vpcsln/spartacus_PCB_REV1/v1sch.csv

Reference | Qty | Value | Footprint | Description
C1,C2,C3,C4,C5,C6,C7,C12,C14,C16,C19,C20,C22,C25,C26,C27,C39,C40,C42,C44,C50,C66,C67,C68,C69,C71,C72,C74,C75,C76,C89,C90,C94,C95,C98,C99 | 36 | 100n | Capacitor_SMD:C_1206_3216Metric_Pad1.33x1.80mm_HandSolder | Unpolarized capacitor,Unpolarized capacitor, small symbol
C8,C9,C41,C45,C77,C78,C79,C82,C83,C84,C91,C93,C102,C103,C104,C105,C106 | 17 | 1u | Capacitor_SMD:C_1206_3216Metric_Pad1.33x1.80mm_HandSolder | Unpolarized capacitor,Unpolarized capacitor, small symbol
C10,C11,C31,C32,C36,C37,C55,C97 | 8 | 22u | Capacitor_SMD:C_1206_3216Metric_Pad1.33x1.80mm_HandSolder | Unpolarized capacitor, small symbol
C13,C17,C18,C21,C23,C38,C43,C51,C52,C53,C70,C100,C101 | 13 | 10u | Capacitor_SMD:C_1206_3216Metric_Pad1.33x1.80mm_HandSolder | Unpolarized capacitor,Unpolarized capacitor, small symbol
C15 | 1 | 1000uF | Capacitor_THT:CP_Radial_D10.0mm_P5.00mm | Unpolarized capacitor, small symbol
C24,C54,C56,C57,C60,C61,C62,C85,C86,C87 | 10 | 2.2u | Capacitor_SMD:C_1206_3216Metric_Pad1.33x1.80mm_HandSolder | Unpolarized capacitor, small symbol
C28,C30,C33,C35 | 4 | 4.7n | Capacitor_SMD:C_1206_3216Metric_Pad1.33x1.80mm_HandSolder | Unpolarized capacitor, small symbol
C29,C34 | 2 | 10n | Capacitor_SMD:C_1206_3216Metric_Pad1.33x1.80mm_HandSolder | Unpolarized capacitor, small symbol
C46,C47,C48,C49 | 4 | 33n | Capacitor_SMD:C_1206_3216Metric_Pad1.33x1.80mm_HandSolder | Unpolarized capacitor, small symbol
C58,C59 | 2 | 47n | Capacitor_SMD:C_1206_3216Metric_Pad1.33x1.80mm_HandSolder | Unpolarized capacitor, small symbol
C63,C64 | 2 | 47p | Capacitor_SMD:C_1206_3216Metric_Pad1.33x1.80mm_HandSolder | Unpolarized capacitor, small symbol
C65,C80,C81,C88,C92,C96 | 6 | 1n | Capacitor_SMD:C_1206_3216Metric_Pad1.33x1.80mm_HandSolder | Unpolarized capacitor, small symbol
C73 | 1 | 470u | Capacitor_THT:CP_Radial_D8.0mm_P3.50mm | Unpolarized capacitor, small symbol
C107 | 1 | 100n | easyeda2kicad:CAP-TH_L4.0-W2.6-P2.5-D0.5 | Unpolarized capacitor, small symbol
C401,C402,C403,C404 | 4 | C_Small | easyeda2kicad:CAP-TH_L4.0-W2.6-P2.5-D0.5 | Unpolarized capacitor, small symbol
C514,C523 | 2 | 390p | easyeda2kicad:CAP-TH_L4.0-W2.6-P2.5-D0.5 | Unpolarized capacitor, small symbol
C515 | 1 | 180p | easyeda2kicad:CAP-TH_L4.0-W2.6-P2.5-D0.5 | Unpolarized capacitor, small symbol
C516,C531,C535 | 3 | 220p | easyeda2kicad:CAP-TH_L4.0-W2.6-P2.5-D0.5 | Unpolarized capacitor, small symbol
C517 | 1 | 820p | easyeda2kicad:CAP-TH_L4.0-W2.6-P2.5-D0.5 | Unpolarized capacitor, small symbol
C518 | 1 | 470p | easyeda2kicad:CAP-TH_L4.0-W2.6-P2.5-D0.5 | Unpolarized capacitor, small symbol
C519,C532,C536 | 3 | 560p | easyeda2kicad:CAP-TH_L4.0-W2.6-P2.5-D0.5 | Unpolarized capacitor, small symbol
C520 | 1 | 56p | easyeda2kicad:CAP-TH_L4.0-W2.6-P2.5-D0.5 | Unpolarized capacitor, small symbol
C521 | 1 | 82p | easyeda2kicad:CAP-TH_L4.0-W2.6-P2.5-D0.5 | Unpolarized capacitor, small symbol
C522,C533,C537 | 3 | 33p | easyeda2kicad:CAP-TH_L4.0-W2.6-P2.5-D0.5 | Unpolarized capacitor, small symbol
C524,C525,C534,C538 | 4 | 270p | easyeda2kicad:CAP-TH_L4.0-W2.6-P2.5-D0.5 | Unpolarized capacitor, small symbol
CN1 | 1 |  | HansAdafruit:DCJACK_2MM_PTH | 2.0mm DC Barrel JackDCJACK_2MM_PTH - Through Hole Jack (4UConnector: 05537)
D2,D3,D4,D5 | 4 | D_Zener | Diode_THT:D_DO-41_SOD81_P3.81mm_Vertical_CathodeUp | Zener diode
D6,D7,D8,D9,D18 | 5 | 1N4148 | Diode_THT:D_DO-35_SOD27_P2.54mm_Vertical_CathodeUp | 100V 0.15A standard switching diode, DO-35
D10,D11,D12,D13,D14,D15,D20,D21,D22,D23 | 10 | 1N4007 | Diode_THT:D_DO-41_SOD81_P3.81mm_Vertical_CathodeUp | 1000V 1A General Purpose Rectifier Diode, DO-41
D16,D17,D19 | 3 | SS14 | Diode_SMD:D_SMA | 40V 1A Schottky Diode, SMA
D24,D25,D26,D27 | 4 | LESD8D5.0CAT5G | Diode_SMD:D_SOD-882D
JP1,JP5,JP8,JP9 | 4 |  | HansPinhead:1X01 | PIN HEADER
JP2 | 1 |  | HansPinhead:1X06 | PIN HEADER
JP3 | 1 |  | HansPinhead:1X08 | PIN HEADER
JP4 | 1 |  | HansPinhead:1X04 | PIN HEADER
JP6 | 1 |  | adafruit:1X03 | PIN HEADER
JP7 | 1 |  | HansPinhead:1X07 | PIN HEADER
JP10,JP11 | 2 |  | HansPinhead:1X03 | PIN HEADER
JP12,JP13 | 2 |  | HansPinhead:2X03 | PIN HEADER
JP14,JP15,JP16,JP17,JP18 | 5 |  | HansPinhead:1X02 | PIN HEADER
JP19,JP20 | 2 |  | adafruit:1X08-BIG | PIN HEADER
L1,L2 | 2 |  | HansToroid:T37_INDUCTOR | Inductor wound on a T37 Toroid
L3,L4,L6,L7,L8,L9,L509,L514,L522 | 9 | 47u | Inductor_THT:L_Axial_L9.5mm_D4.0mm_P2.54mm_Vertical_Fastron_SMCC | Inductor, small symbol
L5 | 1 | 330u | Inductor_THT:L_Axial_L9.5mm_D4.0mm_P2.54mm_Vertical_Fastron_SMCC | Inductor, small symbol
L401 | 1 |  | HansToroid:T50_TAPPED_INDUCTOR_FLAT
L506,L508,L510,L511,L512,L513,L515,L516,L517,L518 | 10 |  | HansToroid:T50_INDUCTOR | Inductor wound on a T37 Toroid
LED1,LED2 | 2 |  | HansAva:HLMP-1790
MIC_2 | 1 |  | HansPinhead:1X02 | PIN HEADER
Q1,Q2,Q16 | 3 | APM4953_C5185739 | easyeda2kicad2:SOP-8_L5.1-W3.9-P1.27-LS6.0-BL
Q3,Q4,Q5,Q6 | 4 |  | easyeda2kicad2:SOT54E_LYING_100_LH2 | N-CHANNEL MOS FET
Q7,Q8,Q9,Q10,Q11,Q13,Q14,Q17,Q28,Q29,Q30,Q31,Q32,Q33 | 14 | BSS123 | Package_TO_SOT_SMD:SOT-23 | 0.17A Id, 100V Vds, N-Channel MOSFET, SOT-23
Q12,Q18,Q19,Q23,Q25 | 5 | BC817 | Package_TO_SOT_SMD:SOT-23 | 0.8A Ic, 45V Vce, NPN Transistor, SOT-23
Q15 | 1 | BSS84 | Package_TO_SOT_SMD:SOT-23 | -0.13A Id, -50V Vds, P-Channel MOSFET, SOT-23
Q20,Q27 | 2 |  | HansTransistor:DPAK4
Q21,Q22,Q24,Q26 | 4 | BC857 | Package_TO_SOT_SMD:SOT-23 | 0.1A Ic, 45V Vce, PNP Transistor, SOT-23
R1,R12,R13,R14,R15,R16,R17,R18,R19,R20,R21,R22,R23,R24,R25,R26,R27,R28,R29,R30,R31,R112,R113,R114,R115 | 25 | 10 | Resistor_SMD:R_1206_3216Metric_Pad1.30x1.75mm_HandSolder | Resistor,Resistor, small symbol
R2,R7,R35,R36,R47,R48,R49,R50,R51,R52,R53,R66,R67,R82,R83,R84,R86,R89,R90,R94,R95,R98,R101,R102,R103,R110,R119,R121,R126,R129,R132,R136,R137,R138,R155,R156,R157 | 37 | 10k | Resistor_SMD:R_1206_3216Metric_Pad1.30x1.75mm_HandSolder | Resistor,Resistor, small symbol
R3,R4,R88,R91,R99,R100,R116,R122,R123,R124 | 10 | 5.1k | Resistor_SMD:R_1206_3216Metric_Pad1.30x1.75mm_HandSolder | Resistor,Resistor, small symbol
R5,R118,R128,R130 | 4 | 47k | Resistor_SMD:R_1206_3216Metric_Pad1.30x1.75mm_HandSolder | Resistor,Resistor, small symbol
R6,R8,R70,R71,R72,R73,R111,R141,R142 | 9 | 470k | Resistor_SMD:R_1206_3216Metric_Pad1.30x1.75mm_HandSolder | Resistor,Resistor, small symbol
R9,R10,R33,R74,R77,R96,R104,R139,R143 | 9 | 1k | Resistor_SMD:R_1206_3216Metric_Pad1.30x1.75mm_HandSolder | Resistor,Resistor, small symbol
R11,R80,R81,R85,R106,R109,R152,R153,R154 | 9 | 100k | Resistor_SMD:R_1206_3216Metric_Pad1.30x1.75mm_HandSolder | Resistor, small symbol
R32,R38,R40,R43,R45,R131,R134,R135,R145,R146 | 10 | 470 | Resistor_SMD:R_1206_3216Metric_Pad1.30x1.75mm_HandSolder | Resistor,Resistor, small symbol
R34,R144 | 2 | 10K | Resistor_SMD:R_1206_3216Metric_Pad1.30x1.75mm_HandSolder | Resistor
R37,R41,R44,R46,R149,R150,R151 | 7 | 47 | Resistor_SMD:R_1206_3216Metric_Pad1.30x1.75mm_HandSolder | Resistor, small symbol
R39,R42 | 2 | 100 | Resistor_SMD:R_1206_3216Metric_Pad1.30x1.75mm_HandSolder | Resistor, small symbol
R54,R55,R58,R59,R92,R93,R107,R108,R147 | 9 | 0 | Resistor_SMD:R_1206_3216Metric_Pad1.30x1.75mm_HandSolder | Resistor, small symbol
R56,R62,R117,R125 | 4 | 5.6k | Resistor_SMD:R_1206_3216Metric_Pad1.30x1.75mm_HandSolder | Resistor, small symbol
R57,R63 | 2 | 3.3k | Resistor_SMD:R_1206_3216Metric_Pad1.30x1.75mm_HandSolder | Resistor, small symbol
R60,R61,R87,R133 | 4 | 22k | Resistor_SMD:R_1206_3216Metric_Pad1.30x1.75mm_HandSolder | Resistor, small symbol
R64,R65 | 2 | 560 | Resistor_SMD:R_1206_3216Metric_Pad1.30x1.75mm_HandSolder | Resistor, small symbol
R68,R69 | 2 | 267k | Resistor_SMD:R_1206_3216Metric_Pad1.30x1.75mm_HandSolder | Resistor, small symbol
R75,R76 | 2 | 33 | Resistor_SMD:R_1206_3216Metric_Pad1.30x1.75mm_HandSolder | Resistor, small symbol
R78,R79 | 2 | 49.9 | Resistor_SMD:R_1206_3216Metric_Pad1.30x1.75mm_HandSolder | Resistor, small symbol
R97,R105,R140 | 3 | 2.2k | Resistor_SMD:R_1206_3216Metric_Pad1.30x1.75mm_HandSolder | Resistor, small symbol
R120,R127 | 2 | 1.91k | Resistor_SMD:R_1206_3216Metric_Pad1.30x1.75mm_HandSolder | Resistor, small symbol
R148 | 1 | 0 | Resistor_SMD:R_01005_0402Metric | Resistor, small symbol
RF1 | 1 | DOSIN-801-0050 | easyeda2kicad:BNC-TH_DOSIN-801-0051
SW6,SW7,SW8,SW9,SW10,SW11,SW12,SW13 | 8 | TS1701-CZ55HBS | easyeda2kicad:SW-TH_4P-L7.5-W5.5-P4.50
T1,T2 | 2 |  | HansToroid:BN43-202-TAP
T3 | 1 |  | HansToroid:BN43-202_BRIDGE | BN43-202 SWR bridge
T5 | 1 |  | HansToroid:BN43-1502_BRIDGE | BN43-202 SWR bridge
T401 | 1 |  | HansToroid:T37_TRIFILAR_TRANSFORMER
U1 | 1 | STM32G474VETx | Package_QFP:LQFP-100_14x14mm_P0.5mm | STMicroelectronics Arm Cortex-M4 MCU, 512KB flash, 128KB RAM, 170 MHz, 1.71-3.6V, 86 GPIO, LQFP100
U2 | 1 | DSC1003DL2-008.0000T | Package_DFN_QFN:CDFN-4_2x2.5mm_P1.65mm
U3,U15,U16,U20,U21,U22,U23,U24 | 8 | UAD8C05L01_C3001951 | easyeda2kicad:SOD-882_L1.0-W0.6-BI
U4 | 1 | UZ1085L-33-TN3-R | Package_TO_SOT_SMD:TO-252-3_TabPin2
U5,U6 | 2 | UCC27524D | Package_SO:SOIC-8_3.9x4.9mm_P1.27mm | Dual 5A MOSFET driver, 4.5V..18V supply, non-inverting, SOIC-8
U7,U8 | 2 | MC74ACT541DTR2G | easyeda2kicad:TSSOP-20_L6.5-W4.4-P0.65-LS6.4-BL
U9,U12 | 2 | TLV9062xD | Package_SO:SOIC-8_3.9x4.9mm_P1.27mm | Dual operational amplifier, 300 uV Offset, SOIC-8
U10,U11 | 2 | SN74CBT3253 | Package_SO:SOIC-16_3.9x9.9mm_P1.27mm | Dual 1 to 4 Analog Multiplexer
U13 | 1 | PCM1821QRTERQ1 | footprints:WQFN20_RTE_TEX
U14 | 1 | NE5532 | Package_SO:SOIC-8_3.9x4.9mm_P1.27mm | Dual Low-Noise Operational Amplifiers, DIP-8/SOIC-8
U17,U18 | 2 | 161N-4BVS11 | easyeda2kicad2:USB-C-SMD_HANELECTRICITY_161N-4XVS11
U19 | 1 | LM1084IT-5.0G | easyeda2kicad:TO-220-3_L9.9-W4.5-P2.54-L
X1,X2,X3 | 3 |  | HansMicEar:PJ320A | MIC/HEADPHONE JACK3.5mm stereo microphone/headphone jackPJ320D
