vpcsln/spartacus_PCB_REV1/v1sch.kicad_pcb

## KiCad design v1sch.kicad_pcb (2026-10-18)

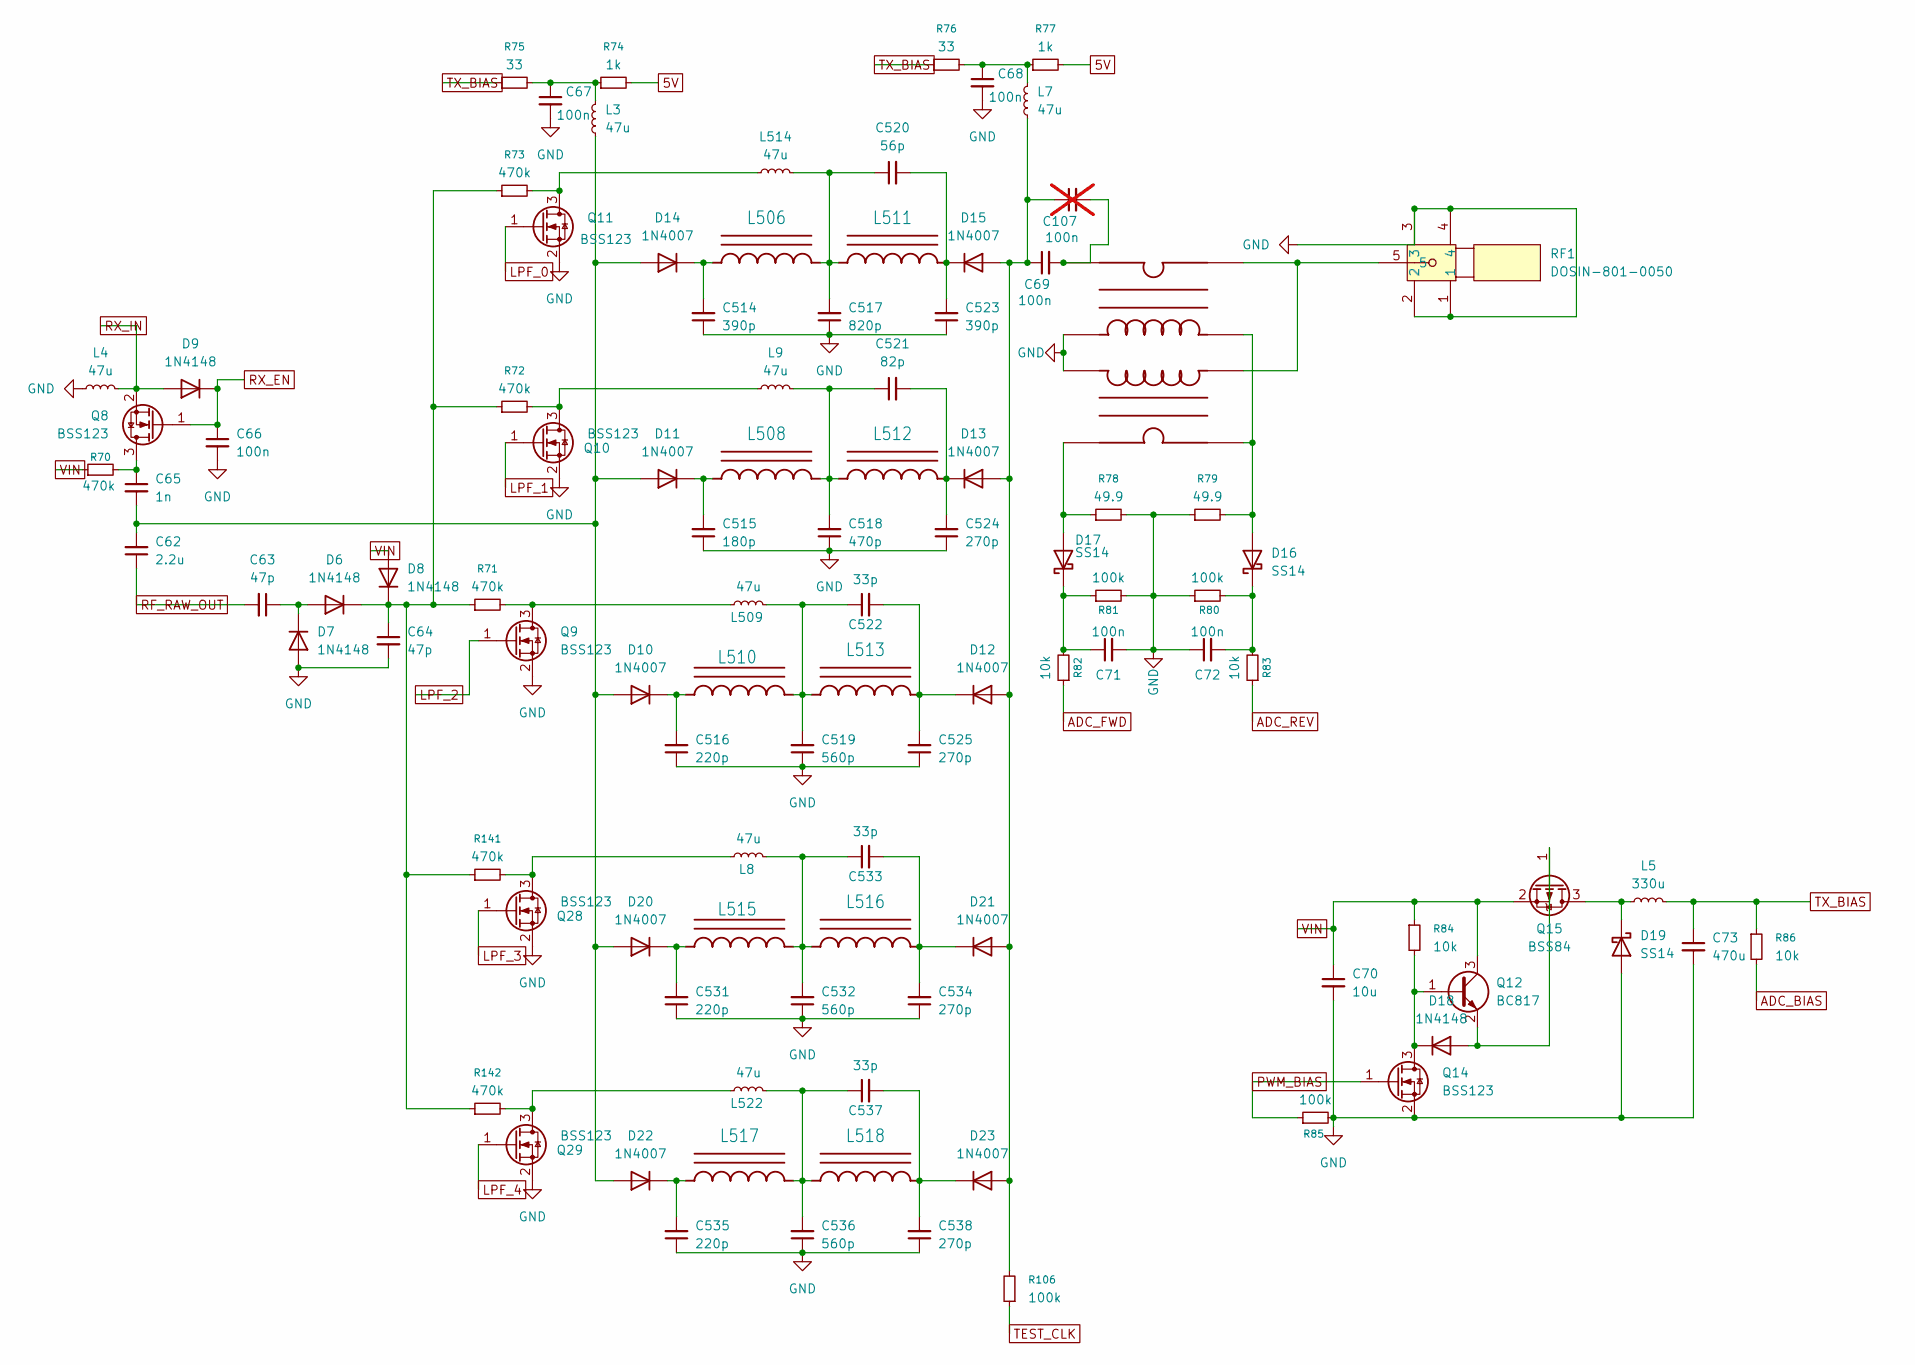
[picture p1: schematic filters.kicad_sch]

Parts:
C62: 2.2u; C_1206_3216Metric_Pad1.33x1.80mm_HandSolder
C63, C64: 47p; C_1206_3216Metric_Pad1.33x1.80mm_HandSolder
C65: 1n; C_1206_3216Metric_Pad1.33x1.80mm_HandSolder
C66, C67, C68, C69, C71, C72: 100n; C_1206_3216Metric_Pad1.33x1.80mm_HandSolder
C70: 10u; C_1206_3216Metric_Pad1.33x1.80mm_HandSolder
C73: 470u; CP_Radial_D8.0mm_P3.50mm
C107: 100n; CAP-TH_L4.0-W2.6-P2.5-D0.5; not fitted
C514, C523: 390p; CAP-TH_L4.0-W2.6-P2.5-D0.5
C515: 180p; CAP-TH_L4.0-W2.6-P2.5-D0.5
C516, C531, C535: 220p; CAP-TH_L4.0-W2.6-P2.5-D0.5
C517: 820p; CAP-TH_L4.0-W2.6-P2.5-D0.5
C518: 470p; CAP-TH_L4.0-W2.6-P2.5-D0.5
C519, C532, C536: 560p; CAP-TH_L4.0-W2.6-P2.5-D0.5
C520: 56p; CAP-TH_L4.0-W2.6-P2.5-D0.5
C521: 82p; CAP-TH_L4.0-W2.6-P2.5-D0.5
C522, C533, C537: 33p; CAP-TH_L4.0-W2.6-P2.5-D0.5
C524, C525, C534, C538: 270p; CAP-TH_L4.0-W2.6-P2.5-D0.5
D6, D7, D8, D9, D18: 1N4148; D_DO-35_SOD27_P2.54mm_Vertical_CathodeUp
D10, D11, D12, D13, D14, D15, D20, D21, D22, D23: 1N4007; D_DO-41_SOD81_P3.81mm_Vertical_CathodeUp
D16, D17, D19: SS14; D_SMA
L3, L4, L7, L8, L9, L509, L514, L522: 47u; L_Axial_L9.5mm_D4.0mm_P2.54mm_Vertical_Fastron_SMCC
L5: 330u; L_Axial_L9.5mm_D4.0mm_P2.54mm_Vertical_Fastron_SMCC
L506, L508, L510, L511, L512, L513, L515, L516, L517, L518: T50_INDUCTOR
Q8, Q9, Q10, Q11, Q14, Q28, Q29: BSS123; SOT-23
Q12: BC817; SOT-23
Q15: BSS84; SOT-23
R70, R71, R72, R73, R141, R142: 470k; R_1206_3216Metric_Pad1.30x1.75mm_HandSolder
R74, R77: 1k; R_1206_3216Metric_Pad1.30x1.75mm_HandSolder
R75, R76: 33; R_1206_3216Metric_Pad1.30x1.75mm_HandSolder
R78, R79: 49.9; R_1206_3216Metric_Pad1.30x1.75mm_HandSolder
R80, R81, R85, R106: 100k; R_1206_3216Metric_Pad1.30x1.75mm_HandSolder
R82, R83, R84, R86: 10k; R_1206_3216Metric_Pad1.30x1.75mm_HandSolder
RF1: DOSIN-801-0050; BNC-TH_DOSIN-801-0051; MPN DOSIN-801-0050; LCSC Part C521210
T5: BN43-1502_BRIDGE

Connections:
5V: R74.2, R77.2; also elsewhere on the board
ADC_BIAS: R86.2; also elsewhere on the board
ADC_FWD: R82.1; also elsewhere on the board
ADC_REV: R83.1; also elsewhere on the board
GND: C64.2, C66.2, C67.2, C68.2, C70.2, C71.2, C72.1, C73.2, C514.1, C515.1, C516.1, C517.1, C518.1, C519.1, C523.1, C524.1, C525.1, C531.1, C532.1, C534.1, C535.1, C536.1, C538.1, D7.2 (A), D19.2 (A), L4.1, Q9.2 (S), Q10.2 (S), Q11.2 (S), Q14.2 (S), Q28.2 (S), Q29.2 (S), R78.2, R79.1, R80.1, R81.2, R85.2, RF1.1, RF1.2, RF1.3, RF1.4, T5.C2B, T5.C3B; also elsewhere on the board
LPF_0: Q11.1 (G); also elsewhere on the board
LPF_1: Q10.1 (G); also elsewhere on the board
LPF_2: Q9.1 (G); also elsewhere on the board
LPF_3: Q28.1 (G); also elsewhere on the board
LPF_4: Q29.1 (G); also elsewhere on the board
unnamed: C67.1, L3.2, R74.1, R75.2
unnamed: C68.1, L7.2, R76.2, R77.1
unnamed: C69.2, C107.2, T5.C4B
unnamed: C517.2, C520.1, L506.CA, L511.CB, L514.2
unnamed: C518.2, C521.1, L9.2, L508.CA, L512.CB
unnamed: C519.2, C522.1, L509.2, L510.CA, L513.CB
unnamed: C532.2, C533.1, L8.2, L515.CA, L516.CB
unnamed: C536.2, C537.1, L517.CA, L518.CB, L522.2
unnamed: C63.1, D6.2 (A), D7.1 (K)
unnamed: C64.1, D6.1 (K), D8.1 (K), R71.1, R72.1, R73.1, R141.1, R142.1
unnamed: C62.2, C65.2, D10.2 (A), D11.2 (A), D14.2 (A), D20.2 (A), D22.2 (A), L3.1
unnamed: C516.2, D10.1 (K), L510.CB
unnamed: C515.2, D11.1 (K), L508.CB
unnamed: C69.1, C107.1, D12.2 (A), D13.2 (A), D15.2 (A), D21.2 (A), D23.2 (A), L7.1, R106.2
unnamed: C522.2, C525.2, D12.1 (K), L513.CA
unnamed: C521.2, C524.2, D13.1 (K), L512.CA
unnamed: C514.2, D14.1 (K), L506.CB
unnamed: C520.2, C523.2, D15.1 (K), L511.CA
unnamed: D16.2 (A), R79.2, T5.C1A, T5.C3A
unnamed: C72.2, D16.1 (K), R80.2, R83.2
unnamed: D17.2 (A), R78.1, T5.C1B
unnamed: C71.1, D17.1 (K), R81.1, R82.2
unnamed: D18.2 (A), Q12.2 (E), Q15.1 (G)
unnamed: D18.1 (K), Q12.1 (B), Q14.3 (D), R84.2
unnamed: D19.1 (K), L5.1, Q15.3 (D)
unnamed: C531.2, D20.1 (K), L515.CB
unnamed: C533.2, C534.2, D21.1 (K), L516.CA
unnamed: C535.2, D22.1 (K), L517.CB
unnamed: C537.2, C538.2, D23.1 (K), L518.CA
unnamed: C65.1, Q8.3 (D), R70.2
unnamed: L509.1, Q9.3 (D), R71.2
unnamed: L9.1, Q10.3 (D), R72.2
unnamed: L514.1, Q11.3 (D), R73.2
unnamed: L8.1, Q28.3 (D), R141.2
unnamed: L522.1, Q29.3 (D), R142.2
unnamed: RF1.5, T5.C2A, T5.C4A
PWM_BIAS: Q14.1 (G), R85.1; also elsewhere on the board
RF_RAW_OUT: C62.1, C63.2; also elsewhere on the board
RX_EN: C66.1, D9.1 (K), Q8.1 (G); also elsewhere on the board
RX_IN: D9.2 (A), L4.2, Q8.2 (S); also elsewhere on the board
TEST_CLK: R106.1; also elsewhere on the board
TX_BIAS: C73.1, L5.2, R75.1, R76.1, R86.1
VIN: C70.1, D8.2 (A), Q12.3 (C), Q15.2 (S), R70.1, R84.1; also elsewhere on the board

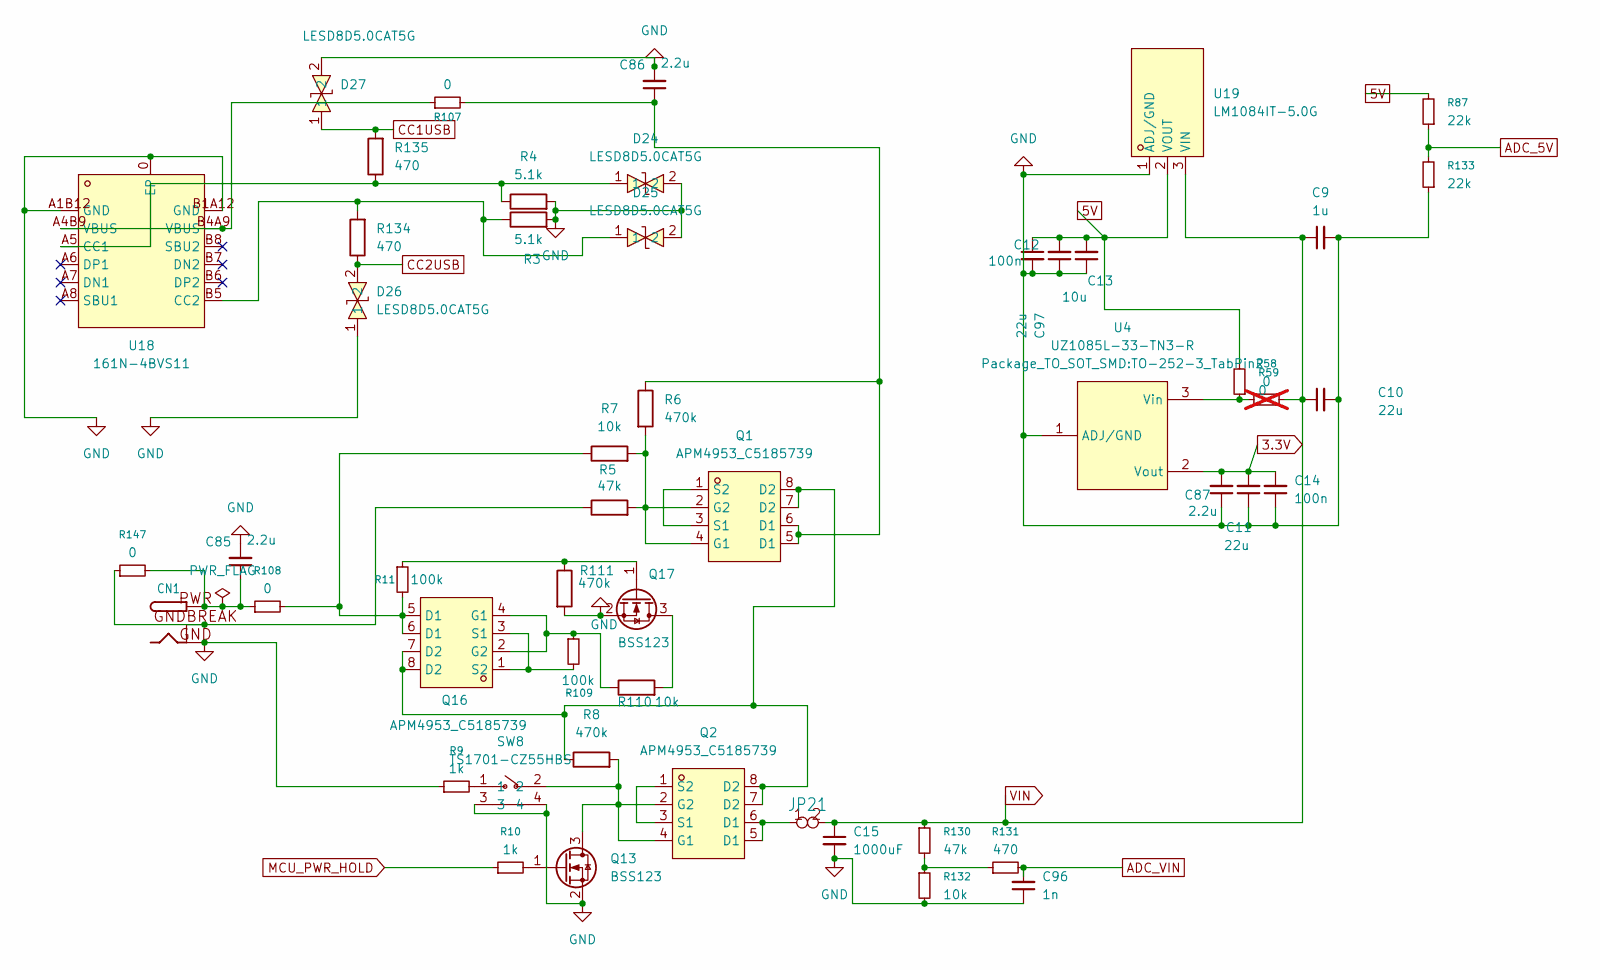
[picture p2: schematic untitled.kicad_sch]

Parts:
C9: 1u; C_1206_3216Metric_Pad1.33x1.80mm_HandSolder
C10, C11, C97: 22u; C_1206_3216Metric_Pad1.33x1.80mm_HandSolder
C12, C14: 100n; C_1206_3216Metric_Pad1.33x1.80mm_HandSolder
C13: 10u; C_1206_3216Metric_Pad1.33x1.80mm_HandSolder
C15: 1000uF; CP_Radial_D10.0mm_P5.00mm
C85, C86, C87: 2.2u; C_1206_3216Metric_Pad1.33x1.80mm_HandSolder
C96: 1n; C_1206_3216Metric_Pad1.33x1.80mm_HandSolder
CN1: DCJACK_2MM_PTH
D24, D25, D26, D27: LESD8D5.0CAT5G; D_SOD-882D; MPN LESD8D5.0CAT5G; LCSC Part C172411
JP21: 1X02
Q1, Q2, Q16: APM4953_C5185739; SOP-8_L5.1-W3.9-P1.27-LS6.0-BL; MPN APM4953(UMW); LCSC Part C5185739
Q13, Q17: BSS123; SOT-23
R3, R4: 5.1k; R_1206_3216Metric_Pad1.30x1.75mm_HandSolder
R5, R130: 47k; R_1206_3216Metric_Pad1.30x1.75mm_HandSolder
R6, R8, R111: 470k; R_1206_3216Metric_Pad1.30x1.75mm_HandSolder
R7, R110, R132: 10k; R_1206_3216Metric_Pad1.30x1.75mm_HandSolder
R9, R10: 1k; R_1206_3216Metric_Pad1.30x1.75mm_HandSolder
R11, R109: 100k; R_1206_3216Metric_Pad1.30x1.75mm_HandSolder
R58: 0; R_1206_3216Metric_Pad1.30x1.75mm_HandSolder; not fitted
R59, R107, R108, R147: 0; R_1206_3216Metric_Pad1.30x1.75mm_HandSolder
R87, R133: 22k; R_1206_3216Metric_Pad1.30x1.75mm_HandSolder
R131, R134, R135: 470; R_1206_3216Metric_Pad1.30x1.75mm_HandSolder
SW8: TS1701-CZ55HBS; SW-TH_4P-L7.5-W5.5-P4.50; MPN TS1701-CZ55HBS; LCSC Part C36938820
U4: UZ1085L-33-TN3-R; TO-252-3_TabPin2; MPN UZ1085L-33-TN3-R; LCSC Part C125622
U18: 161N-4BVS11; USB-C-SMD_HANELECTRICITY_161N-4XVS11; MPN 161N-4BVS11; LCSC Part C5440752
U19: LM1084IT-5.0G; TO-220-3_L9.9-W4.5-P2.54-L; MPN LM1084IT-5.0G; LCSC Part C5145342

Connections:
3.3V: C11.2, C14.2, C87.2, U4.2 (Vout); also elsewhere on the board
5V: C12.2, C13.2, C97.1, R59.2, R87.2, U19.2 (VOUT); also elsewhere on the board
ADC_5V: R87.1, R133.2; also elsewhere on the board
ADC_VIN: C96.2, R131.2; also elsewhere on the board
CC1USB: D27.1, R135.2; also elsewhere on the board
CC2USB: D26.2, R134.1; also elsewhere on the board
GND: C9.2, C10.2, C11.1, C12.1, C13.1, C14.1, C15.2, C85.2, C86.2, C87.1, C96.1, C97.2, CN1.GND, D24.2, D25.2, D26.1, D27.2, Q13.2 (S), Q17.2 (S), R3.2, R4.2, R9.1, R111.2, R132.2, R133.1, SW8.3, SW8.4, U4.1 (ADJ/GND), U18.0 (EP), U18.A1B12 (GND), U18.B1A12 (GND), U19.1 (ADJ/GND); also elsewhere on the board
MCU_PWR_HOLD: R10.1; also elsewhere on the board
unnamed: C85.1, CN1.PWR, R108.1, R147.2
unnamed: C86.1, Q1.5 (D1), Q1.6 (D1), R6.1, R107.2
unnamed: CN1.GNDBREAK, R5.1, R147.1
unnamed: JP21.1, Q2.5 (D1), Q2.6 (D1)
unnamed: Q1.7 (D2), Q1.8 (D2), Q2.7 (D2), Q2.8 (D2), Q16.7 (D2), Q16.8 (D2), R8.1
unnamed: Q1.2 (G2), Q1.4 (G1), R5.2, R6.2, R7.2
unnamed: Q1.1 (S2), Q1.3 (S1)
unnamed: Q2.1 (S2), Q2.3 (S1)
unnamed: Q2.2 (G2), Q2.4 (G1), Q13.3 (D), R8.2, SW8.2
unnamed: Q13.1 (G), R10.2
unnamed: Q16.5 (D1), Q16.6 (D1), R7.1, R11.2, R108.2
unnamed: Q16.2 (G2), Q16.4 (G1), R109.1, R110.1
unnamed: Q16.1 (S2), Q16.3 (S1), R109.2
unnamed: Q17.3 (D), R110.2
unnamed: Q17.1 (G), R11.1, R111.1
unnamed: R9.2, SW8.1
unnamed: R107.1, U18.A4B9 (VBUS), U18.B4A9 (VBUS)
unnamed: R130.2, R131.1, R132.1
unnamed: R58.1, R59.1, U4.3 (Vin)
unnamed: D24.1, R4.1, R135.1, U18.A5 (CC1)
unnamed: D25.1, R3.1, R134.2, U18.B5 (CC2)
VIN: C9.1, C10.1, C15.1, JP21.2, R58.2, R130.1, U19.3 (VIN); also elsewhere on the board

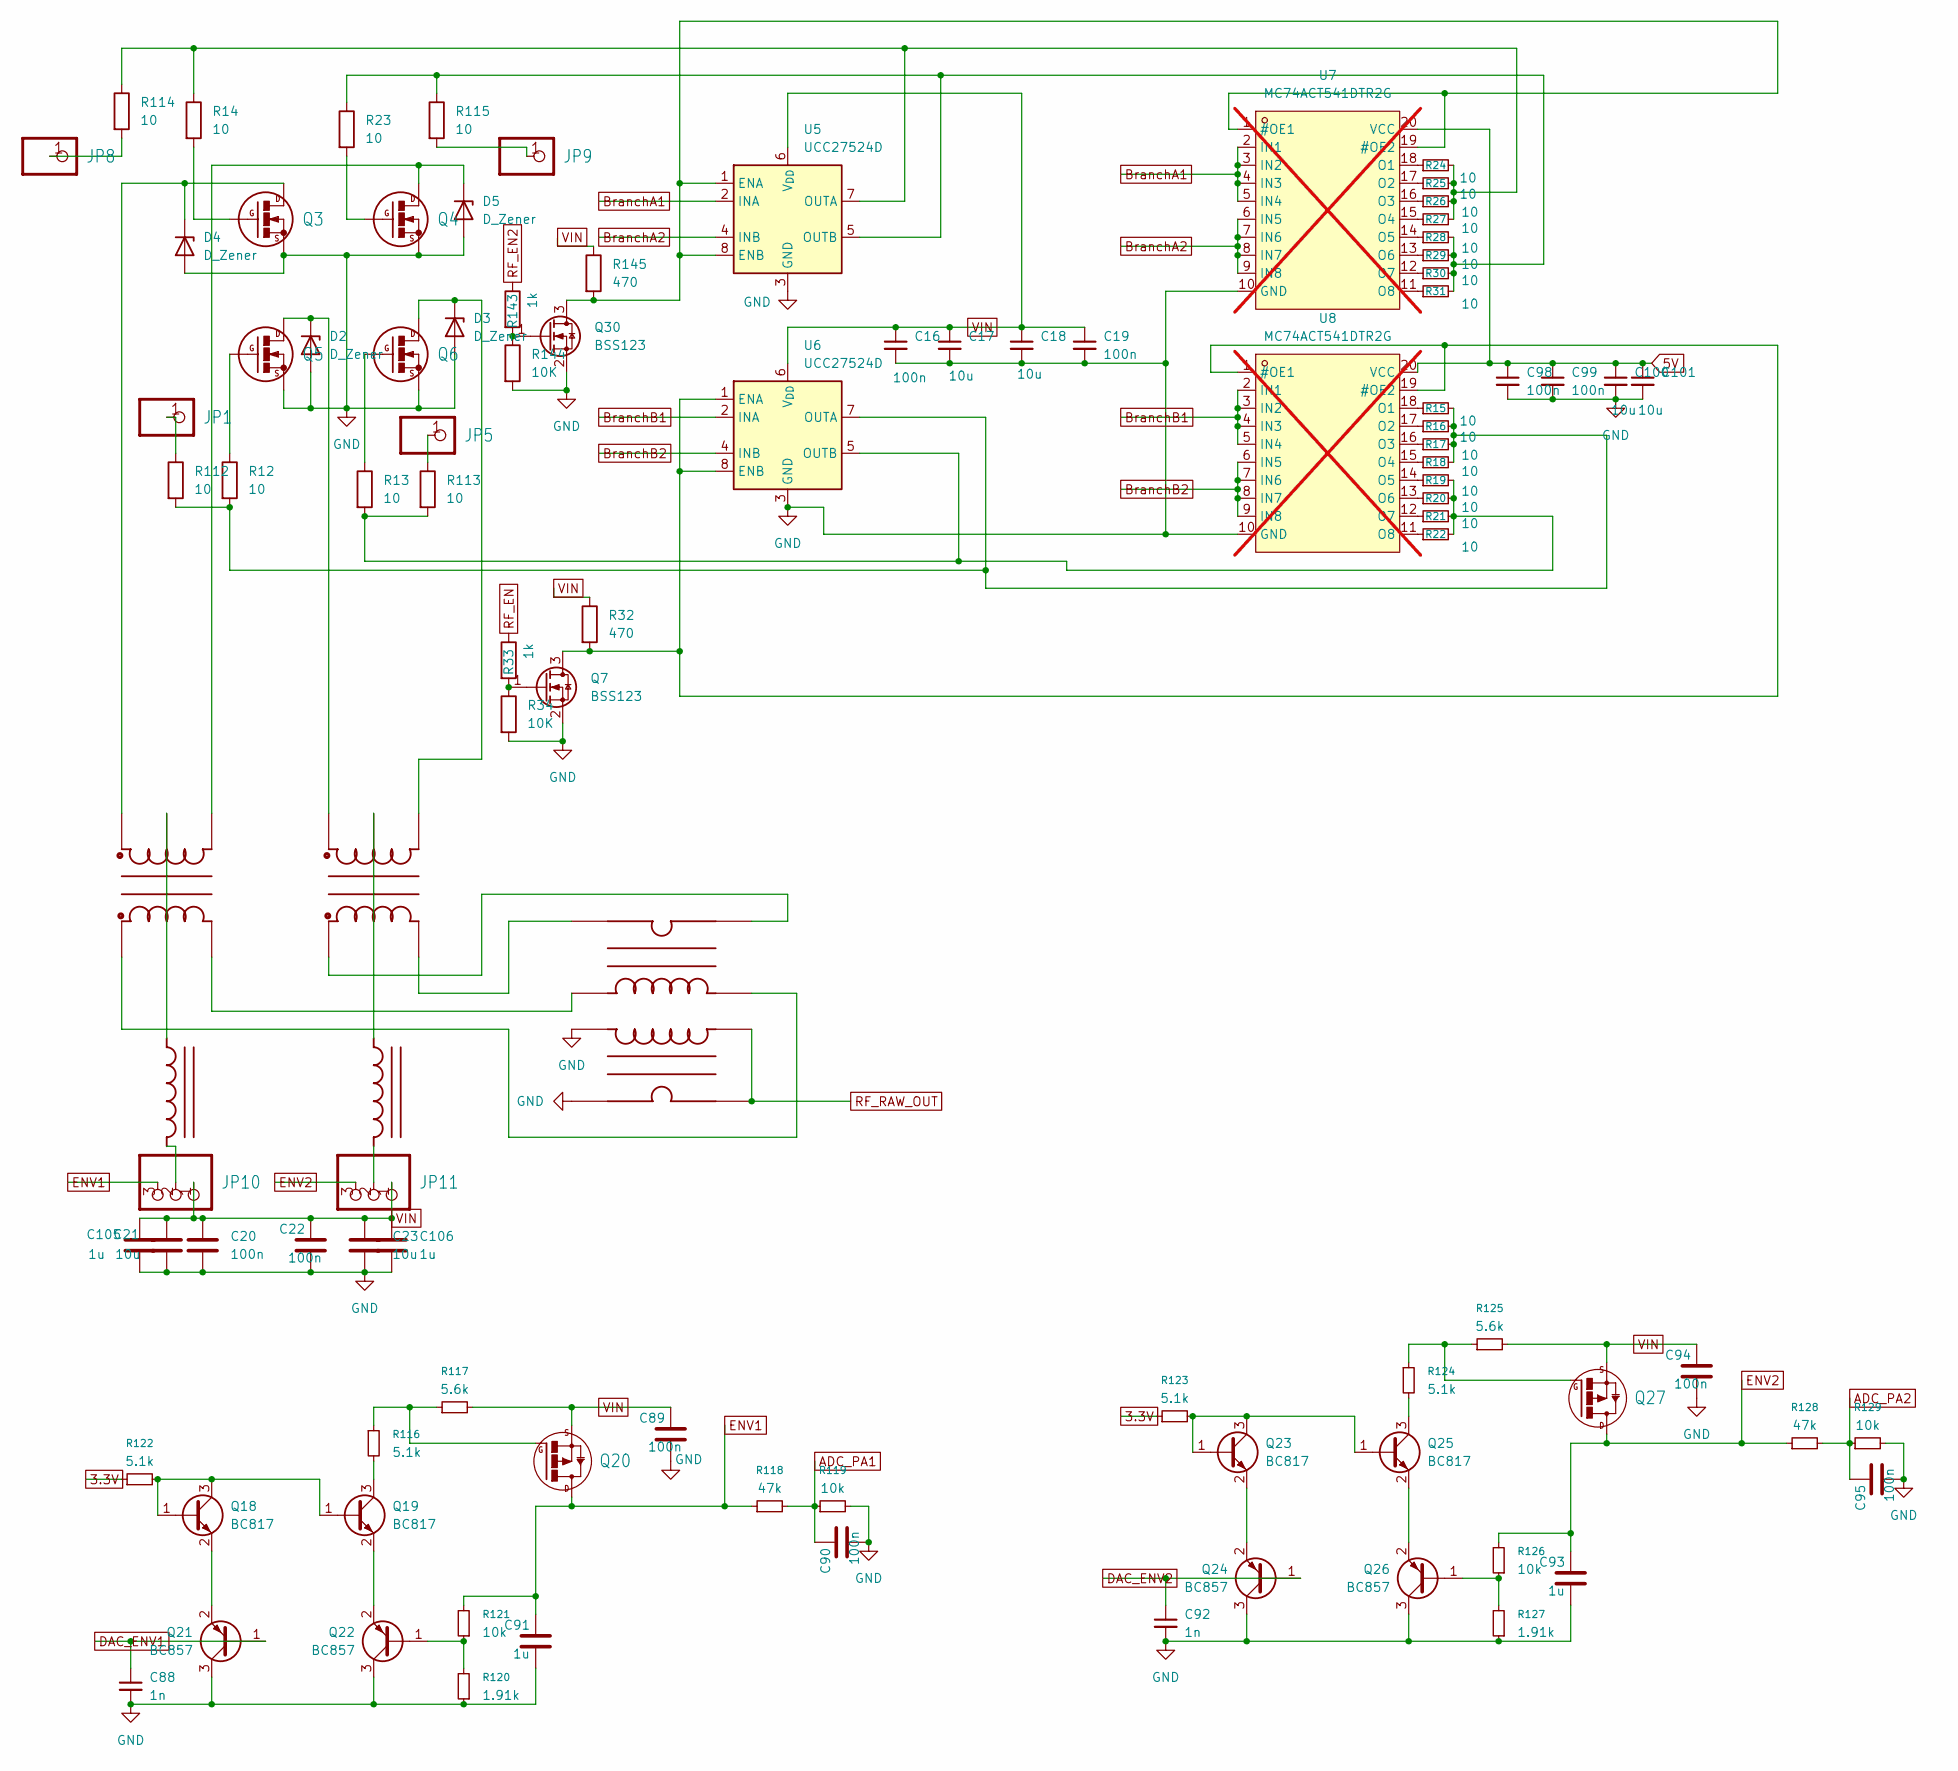
[picture p3: schematic Transmitter.kicad_sch]

Parts:
C16, C19, C20, C22, C89, C90, C94, C95, C98, C99: 100n; C_1206_3216Metric_Pad1.33x1.80mm_HandSolder
C17, C18, C21, C23, C100, C101: 10u; C_1206_3216Metric_Pad1.33x1.80mm_HandSolder
C88, C92: 1n; C_1206_3216Metric_Pad1.33x1.80mm_HandSolder
C91, C93, C105, C106: 1u; C_1206_3216Metric_Pad1.33x1.80mm_HandSolder
D2, D3, D4, D5: D_Zener; D_DO-41_SOD81_P3.81mm_Vertical_CathodeUp
JP1, JP5, JP8, JP9: 1X01
JP10, JP11: 1X03
L1, L2: T37_INDUCTOR
Q3, Q4, Q5, Q6: SOT54E_LYING_100_LH2
Q7, Q30: BSS123; SOT-23
Q18, Q19, Q23, Q25: BC817; SOT-23
Q20, Q27: DPAK4
Q21, Q22, Q24, Q26: BC857; SOT-23
R12, R13, R14, R15, R16, R17, R18, R19, R20, R21, R22, R23, R24, R25, R26, R27, R28, R29, R30, R31, R112, R113, R114, R115: 10; R_1206_3216Metric_Pad1.30x1.75mm_HandSolder
R32, R145: 470; R_1206_3216Metric_Pad1.30x1.75mm_HandSolder
R33, R143: 1k; R_1206_3216Metric_Pad1.30x1.75mm_HandSolder
R34, R144: 10K; R_1206_3216Metric_Pad1.30x1.75mm_HandSolder
R116, R122, R123, R124: 5.1k; R_1206_3216Metric_Pad1.30x1.75mm_HandSolder
R117, R125: 5.6k; R_1206_3216Metric_Pad1.30x1.75mm_HandSolder
R118, R128: 47k; R_1206_3216Metric_Pad1.30x1.75mm_HandSolder
R119, R121, R126, R129: 10k; R_1206_3216Metric_Pad1.30x1.75mm_HandSolder
R120, R127: 1.91k; R_1206_3216Metric_Pad1.30x1.75mm_HandSolder
T1, T2: BN43-202-TAP
T3: BN43-202_BRIDGE
U5, U6: UCC27524D; SOIC-8_3.9x4.9mm_P1.27mm
U7, U8: MC74ACT541DTR2G; TSSOP-20_L6.5-W4.4-P0.65-LS6.4-BL; MPN MC74ACT541DTR2G; LCSC Part C8112; not fitted

Connections:
3.3V: R122.1, R123.1; also elsewhere on the board
5V: C98.1, C99.1, C100.1, C101.1, U7.20 (VCC), U8.20 (VCC); also elsewhere on the board
ADC_PA1: C90.1, R118.2, R119.1; also elsewhere on the board
ADC_PA2: C95.1, R128.2, R129.1; also elsewhere on the board
BranchA1: U5.2 (INA), U7.2 (IN1), U7.3 (IN2), U7.4 (IN3), U7.5 (IN4); also elsewhere on the board
BranchA2: U5.4 (INB), U7.6 (IN5), U7.7 (IN6), U7.8 (IN7), U7.9 (IN8); also elsewhere on the board
BranchB1: U6.2 (INA), U8.2 (IN1), U8.3 (IN2), U8.4 (IN3), U8.5 (IN4); also elsewhere on the board
BranchB2: U6.4 (INB), U8.6 (IN5), U8.7 (IN6), U8.8 (IN7), U8.9 (IN8); also elsewhere on the board
DAC_ENV1: C88.1, Q21.1 (B); also elsewhere on the board
DAC_ENV2: C92.1, Q24.1 (B); also elsewhere on the board
ENV1: C91.1, JP10.3, Q20.4 (D), R118.1, R121.2
ENV2: C93.1, JP11.3, Q27.4 (D), R126.2, R128.1
GND: C16.2, C17.2, C18.2, C19.2, C20.2, C21.2, C22.2, C23.2, C88.2, C89.2, C90.2, C91.2, C92.2, C93.2, C94.2, C95.2, C98.2, C99.2, C100.2, C101.2, C105.2, C106.2, D2.2 (A), D3.2 (A), D4.2 (A), D5.2 (A), Q3.S, Q4.S, Q5.S, Q6.S, Q7.2 (S), Q21.3 (C), Q22.3 (C), Q24.3 (C), Q26.3 (C), Q30.2 (S), R34.2, R119.2, R120.1, R127.1, R129.2, R144.2, T3.C1B, T3.C2B, U5.3 (GND), U6.3 (GND), U7.10 (GND), U8.10 (GND); also elsewhere on the board
unnamed: D2.1 (K), Q5.D, T2.C2B
unnamed: D3.1 (K), Q6.D, T2.C2A
unnamed: D4.1 (K), Q3.D, T1.C2B
unnamed: D5.1 (K), Q4.D, T1.C2A
unnamed: JP1.1 (1_1), R112.1
unnamed: JP5.1 (1_1), R113.1
unnamed: JP8.1 (1_1), R114.2
unnamed: JP9.1 (1_1), R115.2
unnamed: JP10.2, L1.CA
unnamed: JP11.2, L2.CA
unnamed: L1.CB, T1.C2C
unnamed: L2.CB, T2.C2C
unnamed: Q3.G, R14.2
unnamed: Q4.G, R23.2
unnamed: Q5.G, R12.1
unnamed: Q6.G, R13.1
unnamed: Q7.3 (D), R32.2, U6.1 (ENA), U6.8 (ENB), U8.1 (#OE1), U8.19 (#OE2)
unnamed: Q7.1 (G), R33.2, R34.1
unnamed: Q18.1 (B), Q18.3 (C), Q19.1 (B), R122.2
unnamed: Q18.2 (E), Q21.2 (E)
unnamed: Q19.3 (C), R116.2
unnamed: Q19.2 (E), Q22.2 (E)
unnamed: Q20.1 (G), R116.1, R117.1
unnamed: Q22.1 (B), R120.2, R121.1
unnamed: Q23.1 (B), Q23.3 (C), Q25.1 (B), R123.2
unnamed: Q23.2 (E), Q24.2 (E)
unnamed: Q25.3 (C), R124.2
unnamed: Q25.2 (E), Q26.2 (E)
unnamed: Q26.1 (B), R126.1, R127.2
unnamed: Q27.1 (G), R124.1, R125.1
unnamed: Q30.3 (D), R145.2, U5.1 (ENA), U5.8 (ENB), U7.1 (#OE1), U7.19 (#OE2)
unnamed: Q30.1 (G), R143.2, R144.1
unnamed: T1.C1A, T3.C3B
unnamed: T1.C1B, T3.C3A
unnamed: T2.C1A, T3.C4B
unnamed: T2.C1B, T3.C4A
unnamed: R14.1, R24.2, R25.2, R26.2, R27.2, R114.1, U5.7 (OUTA)
unnamed: R23.1, R28.2, R29.2, R30.2, R31.2, R115.1, U5.5 (OUTB)
unnamed: R12.2, R15.2, R16.2, R17.2, R18.2, R112.2, U6.7 (OUTA)
unnamed: R13.2, R19.2, R20.2, R21.2, R22.2, R113.2, U6.5 (OUTB)
unnamed: R24.1, U7.18 (O1)
unnamed: R25.1, U7.17 (O2)
unnamed: R26.1, U7.16 (O3)
unnamed: R27.1, U7.15 (O4)
unnamed: R28.1, U7.14 (O5)
unnamed: R29.1, U7.13 (O6)
unnamed: R30.1, U7.12 (O7)
unnamed: R31.1, U7.11 (O8)
unnamed: R15.1, U8.18 (O1)
unnamed: R16.1, U8.17 (O2)
unnamed: R17.1, U8.16 (O3)
unnamed: R18.1, U8.15 (O4)
unnamed: R19.1, U8.14 (O5)
unnamed: R20.1, U8.13 (O6)
unnamed: R21.1, U8.12 (O7)
unnamed: R22.1, U8.11 (O8)
RF_EN: R33.1; also elsewhere on the board
RF_EN2: R143.1; also elsewhere on the board
RF_RAW_OUT: T3.C1A, T3.C2A; also elsewhere on the board
VIN: C16.1, C17.1, C18.1, C19.1, C20.1, C21.1, C22.1, C23.1, C89.1, C94.1, C105.1, C106.1, JP10.1, JP11.1, Q20.3 (S), Q27.3 (S), R32.1, R117.2, R125.2, R145.1, U5.6 (V_{DD}), U6.6 (V_{DD}); also elsewhere on the board

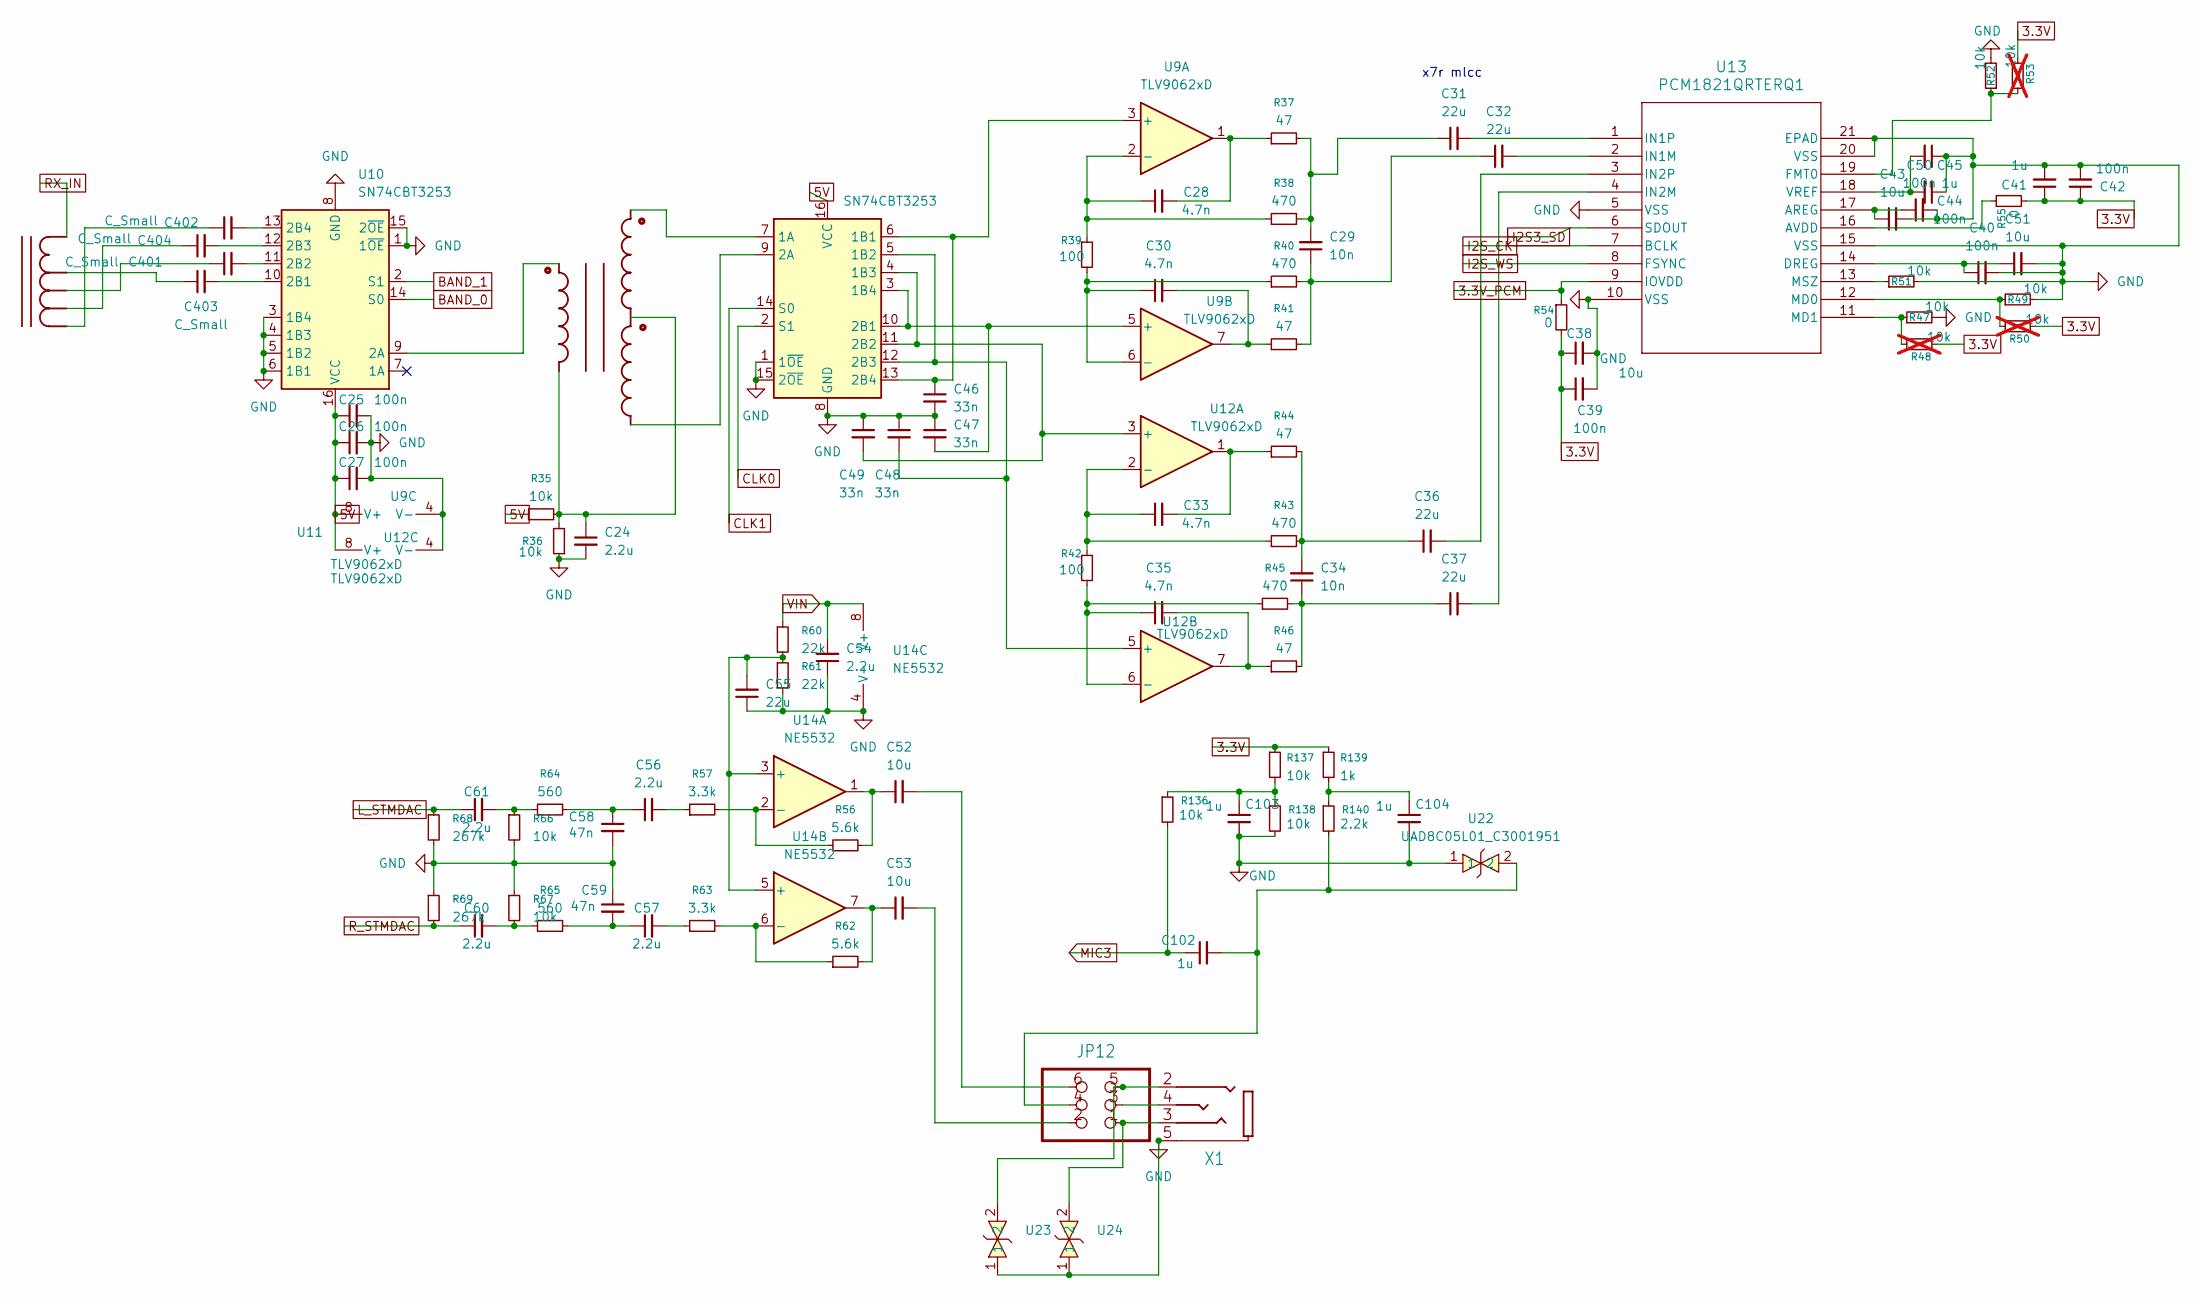
[picture p4: schematic receiver.kicad_sch]

Parts:
C24, C54, C56, C57, C60, C61: 2.2u; C_1206_3216Metric_Pad1.33x1.80mm_HandSolder
C25, C26, C27, C39, C40, C42, C44, C50: 100n; C_1206_3216Metric_Pad1.33x1.80mm_HandSolder
C28, C30, C33, C35: 4.7n; C_1206_3216Metric_Pad1.33x1.80mm_HandSolder
C29, C34: 10n; C_1206_3216Metric_Pad1.33x1.80mm_HandSolder
C31, C32, C36, C37, C55: 22u; C_1206_3216Metric_Pad1.33x1.80mm_HandSolder
C38, C43, C51, C52, C53: 10u; C_1206_3216Metric_Pad1.33x1.80mm_HandSolder
C41, C45, C102, C103, C104: 1u; C_1206_3216Metric_Pad1.33x1.80mm_HandSolder
C46, C47, C48, C49: 33n; C_1206_3216Metric_Pad1.33x1.80mm_HandSolder
C58, C59: 47n; C_1206_3216Metric_Pad1.33x1.80mm_HandSolder
C401, C402, C403, C404: C_Small; CAP-TH_L4.0-W2.6-P2.5-D0.5
JP12: 2X03
L401: T50_TAPPED_INDUCTOR_FLAT
R35, R36, R47, R49, R51, R52, R66, R67, R136, R137, R138: 10k; R_1206_3216Metric_Pad1.30x1.75mm_HandSolder
R37, R41, R44, R46: 47; R_1206_3216Metric_Pad1.30x1.75mm_HandSolder
R38, R40, R43, R45: 470; R_1206_3216Metric_Pad1.30x1.75mm_HandSolder
R39, R42: 100; R_1206_3216Metric_Pad1.30x1.75mm_HandSolder
R48, R50, R53: 10k; R_1206_3216Metric_Pad1.30x1.75mm_HandSolder; not fitted
R54, R55: 0; R_1206_3216Metric_Pad1.30x1.75mm_HandSolder
R56, R62: 5.6k; R_1206_3216Metric_Pad1.30x1.75mm_HandSolder
R57, R63: 3.3k; R_1206_3216Metric_Pad1.30x1.75mm_HandSolder
R60, R61: 22k; R_1206_3216Metric_Pad1.30x1.75mm_HandSolder
R64, R65: 560; R_1206_3216Metric_Pad1.30x1.75mm_HandSolder
R68, R69: 267k; R_1206_3216Metric_Pad1.30x1.75mm_HandSolder
R139: 1k; R_1206_3216Metric_Pad1.30x1.75mm_HandSolder
R140: 2.2k; R_1206_3216Metric_Pad1.30x1.75mm_HandSolder
T401: T37_TRIFILAR_TRANSFORMER
U9, U12: TLV9062xD; SOIC-8_3.9x4.9mm_P1.27mm
U10, U11: SN74CBT3253; SOIC-16_3.9x9.9mm_P1.27mm
U13: PCM1821QRTERQ1; WQFN20_RTE_TEX
U14: NE5532; SOIC-8_3.9x4.9mm_P1.27mm
U22, U23, U24: UAD8C05L01_C3001951; SOD-882_L1.0-W0.6-BI; MPN UAD8C05L01(UMW); LCSC Part C3001951
X1: PJ320A

Connections:
3.3V: C38.1, C39.1, C41.1, C42.1, R48.2, R50.2, R53.2, R54.2, R55.2, R137.1, R139.1; also elsewhere on the board
3.3V_PCM: R54.1, U13.9 (IOVDD)
5V: C25.1, C26.1, C27.1, R35.1, U9.8 (V+), U10.16 (VCC), U11.16 (VCC), U12.8 (V+); also elsewhere on the board
BAND_0: U10.14 (S0); also elsewhere on the board
BAND_1: U10.2 (S1); also elsewhere on the board
CLK0: U11.2 (S1); also elsewhere on the board
CLK1: U11.14 (S0); also elsewhere on the board
GND: C24.2, C25.2, C26.2, C27.2, C38.2, C39.2, C40.2, C41.2, C42.2, C43.2, C44.1, C45.1, C46.2, C47.1, C48.1, C49.1, C50.2, C51.2, C54.1, C55.1, C58.2, C59.1, C103.2, C104.2, R36.1, R47.2, R49.2, R51.2, R52.2, R61.2, R66.2, R67.1, R68.2, R69.1, R138.2, U9.4 (V-), U10.1 (1~OE), U10.3 (1B4), U10.4 (1B3), U10.5 (1B2), U10.6 (1B1), U10.8 (GND), U10.15 (2~OE), U11.1 (1~OE), U11.8 (GND), U11.15 (2~OE), U12.4 (V-), U13.5 (VSS), U13.10 (VSS), U13.15 (VSS), U13.20 (VSS), U13.21 (EPAD), U14.4 (V-), U22.1, U23.1, U24.1, X1.5; also elsewhere on the board
I2S3_SD: U13.6 (SDOUT); also elsewhere on the board
I2S_CK: U13.7 (BCLK); also elsewhere on the board
I2S_WS: U13.8 (FSYNC); also elsewhere on the board
L_STMDAC: C61.1, R68.1; also elsewhere on the board
MIC3: C102.1, R136.2; also elsewhere on the board
unnamed: C24.1, R35.2, R36.2, T401.C1A, T401.C2A, T401.C3B
unnamed: C28.2, R37.1, U9.1
unnamed: C29.1, C32.1, R40.2, R41.2
unnamed: C29.2, C31.1, R37.2, R38.2
unnamed: C30.2, R41.1, U9.7
unnamed: C33.2, R44.1, U12.1
unnamed: C34.1, C37.1, R45.2, R46.2
unnamed: C34.2, C36.1, R43.2, R44.2
unnamed: C35.2, R46.1, U12.7
unnamed: C52.1, R56.2, U14.1
unnamed: C52.2, JP12.6
unnamed: C53.1, R62.2, U14.7
unnamed: C53.2, JP12.2
unnamed: C56.1, C58.1, R64.2
unnamed: C56.2, R57.1
unnamed: C57.1, C59.2, R65.2
unnamed: C57.2, R63.1
unnamed: C60.2, R65.1, R67.2
unnamed: C61.2, R64.1, R66.1
unnamed: C102.2, JP12.4, R140.2, U22.2
unnamed: C103.1, R136.1, R137.2, R138.1
unnamed: C104.1, R139.2, R140.1
unnamed: JP12.1, U24.2, X1.3
unnamed: JP12.3, X1.4
unnamed: JP12.5, U23.2, X1.2
unnamed: C403.1, L401.C1B (CB)
unnamed: C401.1, L401.C1C (CC)
unnamed: C404.1, L401.C1D (CD)
unnamed: C402.1, L401.C1E (CE)
unnamed: C28.1, R38.1, R39.1, U9.2 (-)
unnamed: C30.1, R39.2, R40.1, U9.6 (-)
unnamed: T401.C1B, U10.9 (2A)
unnamed: C403.2, U10.10 (2B1)
unnamed: C401.2, U10.11 (2B2)
unnamed: C404.2, U10.12 (2B3)
unnamed: C402.2, U10.13 (2B4)
unnamed: T401.C2B, U11.7 (1A)
unnamed: C46.1, U9.3 (+), U11.6 (1B1), U11.13 (2B4)
unnamed: C48.2, U11.5 (1B2), U11.12 (2B3), U12.5 (+)
unnamed: C49.2, U11.4 (1B3), U11.11 (2B2), U12.3 (+)
unnamed: C47.2, U9.5 (+), U11.3 (1B4), U11.10 (2B1)
unnamed: T401.C3A, U11.9 (2A)
unnamed: C33.1, R42.1, R43.1, U12.2 (-)
unnamed: C35.1, R42.2, R45.1, U12.6 (-)
unnamed: C43.1, C50.1, U13.17 (AREG)
unnamed: R55.1, U13.16 (AVDD)
unnamed: C40.1, C51.1, U13.14 (DREG)
unnamed: R52.1, R53.1, U13.19 (FMT0)
unnamed: C32.2, U13.2 (IN1M)
unnamed: C31.2, U13.1 (IN1P)
unnamed: C37.2, U13.4 (IN2M)
unnamed: C36.2, U13.3 (IN2P)
unnamed: R49.1, R50.1, U13.12 (MD0)
unnamed: R47.1, R48.1, U13.11 (MD1)
unnamed: R51.1, U13.13 (MSZ)
unnamed: C44.2, C45.2, U13.18 (VREF)
unnamed: C55.2, R60.2, R61.1, U14.3 (+), U14.5 (+)
unnamed: R56.1, R57.2, U14.2 (-)
unnamed: R62.1, R63.2, U14.6 (-)
RX_IN: L401.C1A (CA); also elsewhere on the board
R_STMDAC: C60.1, R69.2; also elsewhere on the board
VIN: C54.2, R60.1, U14.8 (V+); also elsewhere on the board

Notes on the sheet:
x7r mlcc
