vpcsln/spartacus_PCB_REV1/v1sch.kicad_pcb

## KiCad design v1sch.kicad_pcb (continued)

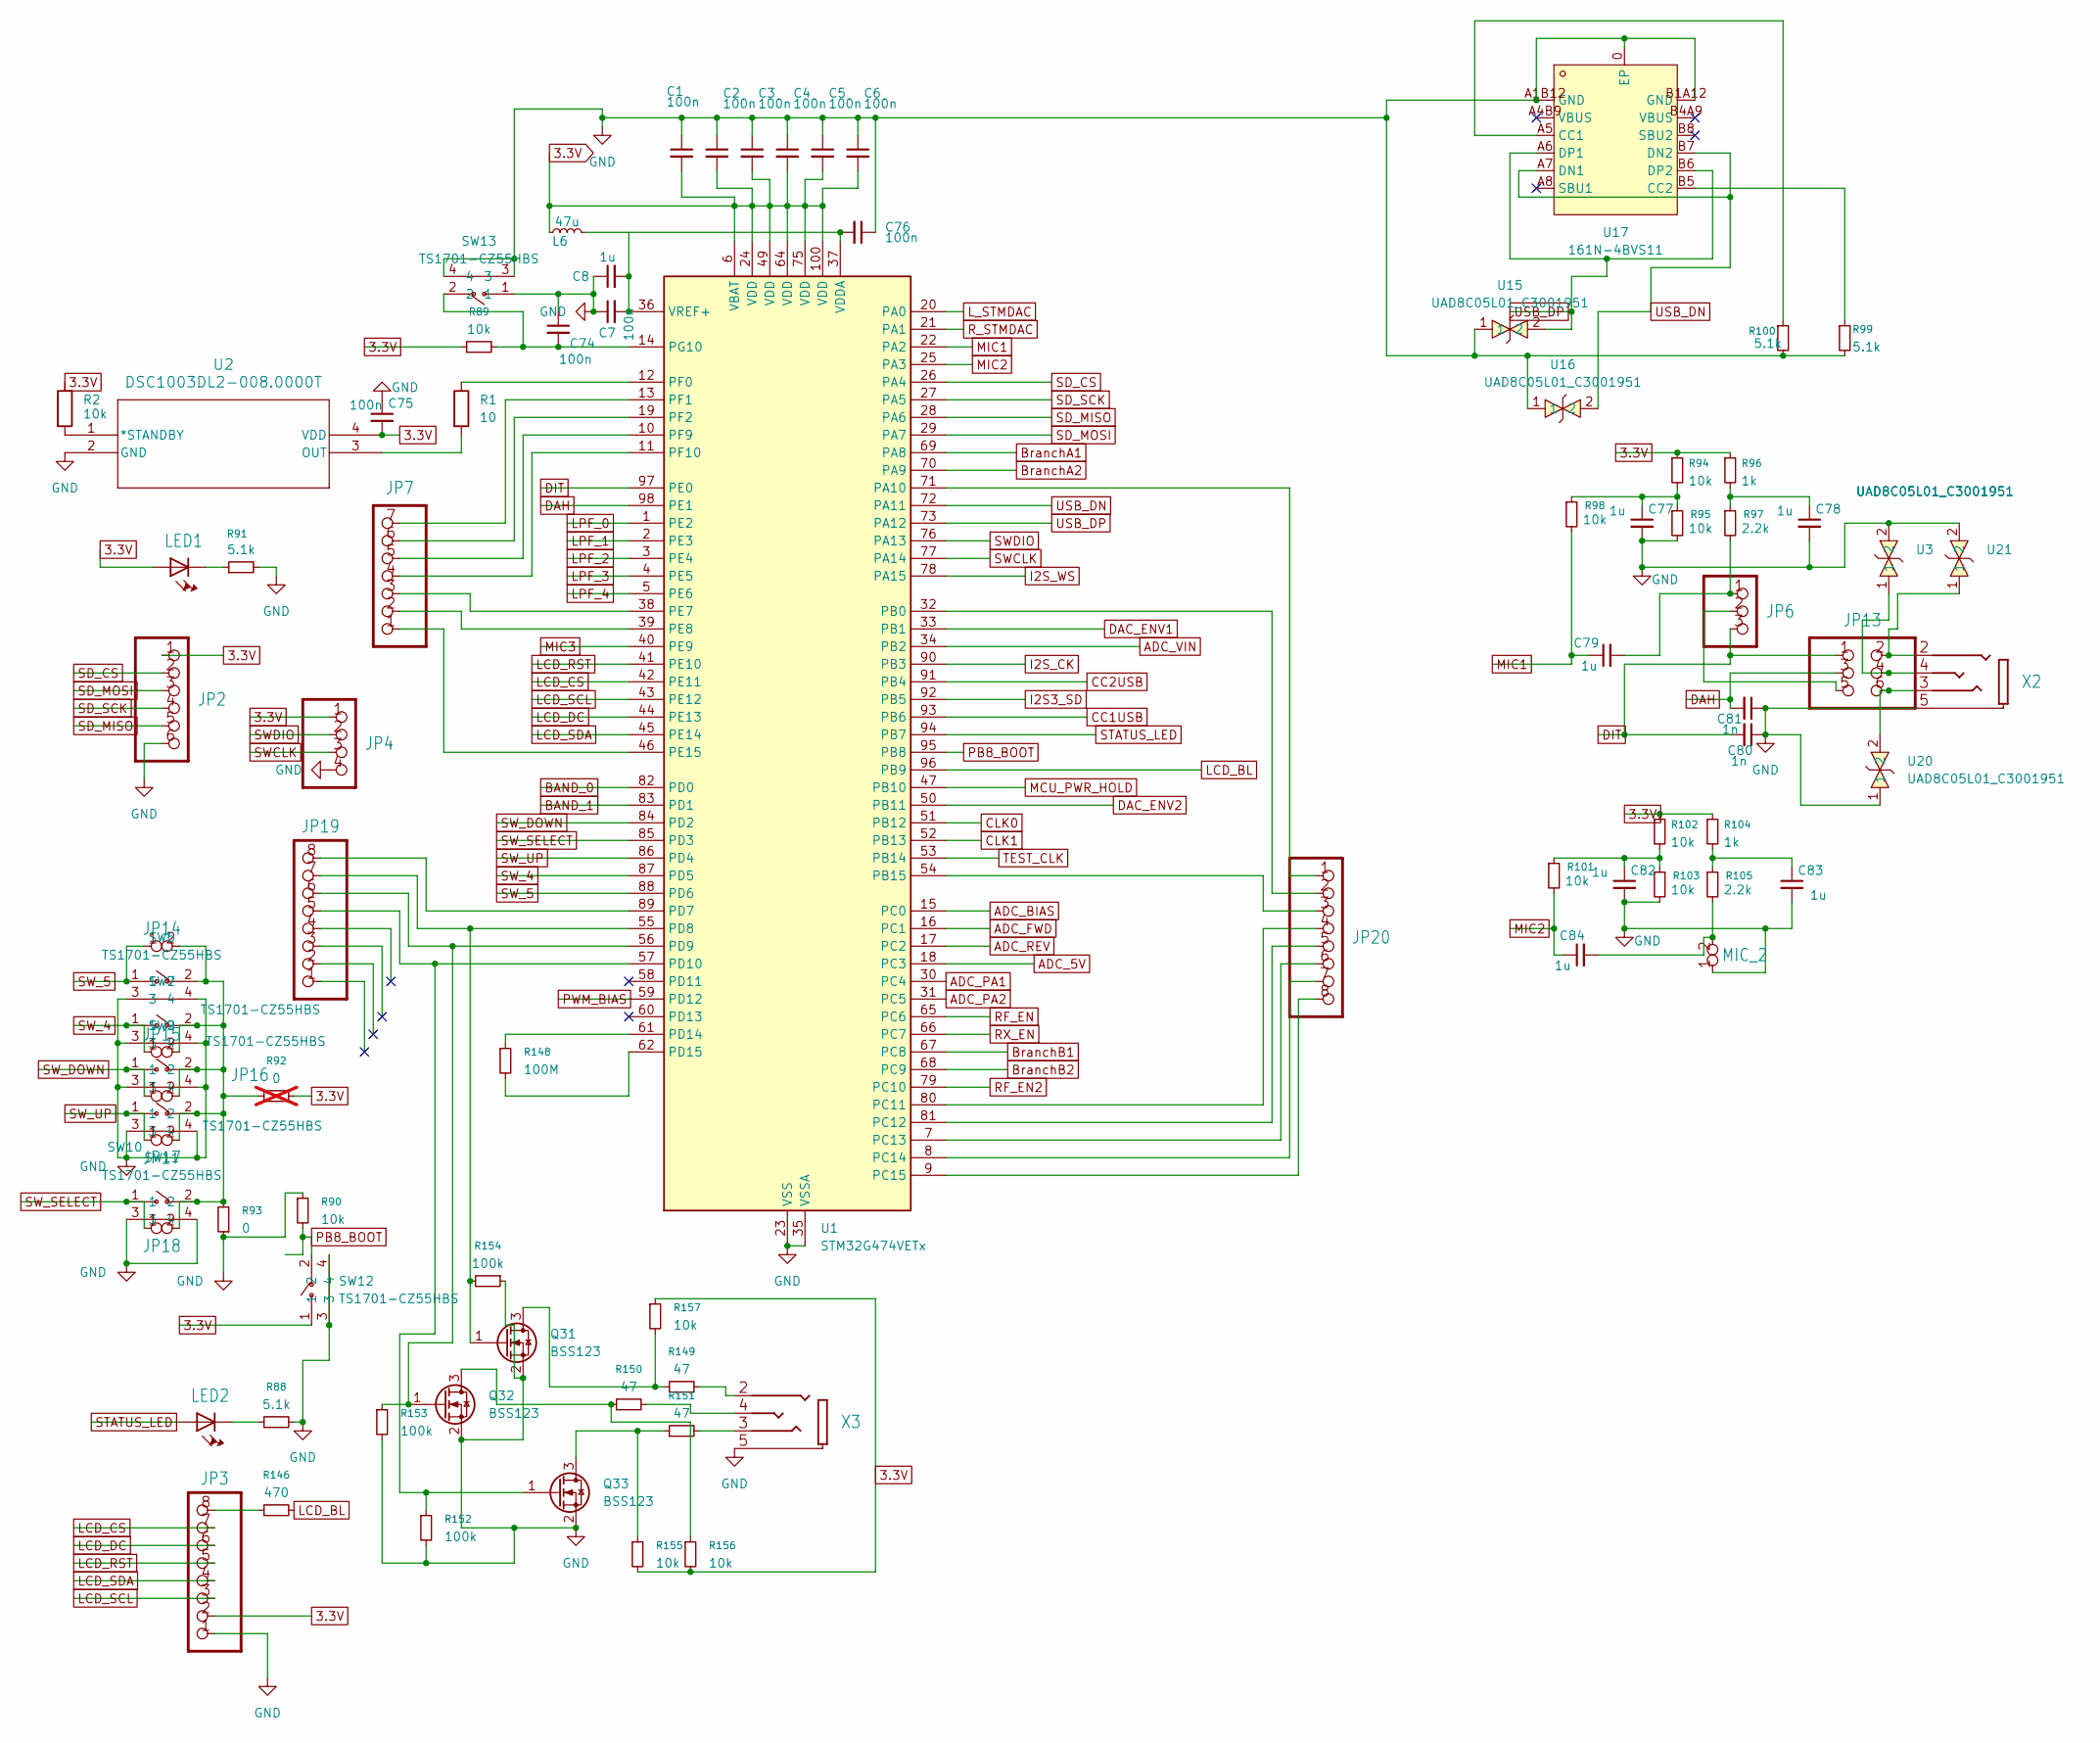
[picture p5: schematic Control_MCU.kicad_sch]

Parts:
C1, C2, C3, C4, C5, C6, C7, C74, C75, C76: 100n; C_1206_3216Metric_Pad1.33x1.80mm_HandSolder
C8, C77, C78, C79, C82, C83, C84: 1u; C_1206_3216Metric_Pad1.33x1.80mm_HandSolder
C80, C81: 1n; C_1206_3216Metric_Pad1.33x1.80mm_HandSolder
JP2: 1X06
JP3: 1X08
JP4: 1X04
JP6: 1X03
JP7: 1X07
JP13: 2X03
JP14, JP15, JP16, JP17, JP18: 1X02
JP19, JP20: 1X08-BIG
L6: 47u; L_Axial_L9.5mm_D4.0mm_P2.54mm_Vertical_Fastron_SMCC
LED1, LED2: HLMP-1790
MIC_2: 1X02
Q31, Q32, Q33: BSS123; SOT-23
R1: 10; R_1206_3216Metric_Pad1.30x1.75mm_HandSolder
R2, R89, R90, R94, R95, R98, R101, R102, R103, R155, R156, R157: 10k; R_1206_3216Metric_Pad1.30x1.75mm_HandSolder
R88, R91, R99, R100: 5.1k; R_1206_3216Metric_Pad1.30x1.75mm_HandSolder
R92: 0; R_1206_3216Metric_Pad1.30x1.75mm_HandSolder; not fitted
R93: 0; R_1206_3216Metric_Pad1.30x1.75mm_HandSolder
R96, R104: 1k; R_1206_3216Metric_Pad1.30x1.75mm_HandSolder
R97, R105: 2.2k; R_1206_3216Metric_Pad1.30x1.75mm_HandSolder
R146: 470; R_1206_3216Metric_Pad1.30x1.75mm_HandSolder
R148: 100M; R_01005_0402Metric
R149, R150, R151: 47; R_1206_3216Metric_Pad1.30x1.75mm_HandSolder
R152, R153, R154: 100k; R_1206_3216Metric_Pad1.30x1.75mm_HandSolder
SW6, SW7, SW9, SW10, SW11, SW12, SW13: TS1701-CZ55HBS; SW-TH_4P-L7.5-W5.5-P4.50; MPN TS1701-CZ55HBS; LCSC Part C36938820
U1: STM32G474VETx; LQFP-100_14x14mm_P0.5mm
U2: DSC1003DL2-008.0000T; CDFN-4_2x2.5mm_P1.65mm
U3, U15, U16, U20, U21: UAD8C05L01_C3001951; SOD-882_L1.0-W0.6-BI; MPN UAD8C05L01(UMW); LCSC Part C3001951
U17: 161N-4BVS11; USB-C-SMD_HANELECTRICITY_161N-4XVS11; MPN 161N-4BVS11; LCSC Part C5440752
X2, X3: PJ320A

Connections:
3.3V: C1.2, C2.2, C3.2, C4.2, C5.2, C6.2, C75.2, JP2.1, JP3.2, JP4.1, L6.1, LED1.A, R2.1, R89.1, R92.2, R94.1, R96.1, R102.1, R104.1, R155.2, R156.2, R157.1, SW12.1, U1.6 (VBAT), U1.24 (VDD), U1.49 (VDD), U1.64 (VDD), U1.75 (VDD), U1.100 (VDD), U2.4 (VDD); also elsewhere on the board
ADC_5V: U1.18 (PC3); also elsewhere on the board
ADC_BIAS: U1.15 (PC0); also elsewhere on the board
ADC_FWD: U1.16 (PC1); also elsewhere on the board
ADC_PA1: U1.30 (PC4); also elsewhere on the board
ADC_PA2: U1.31 (PC5); also elsewhere on the board
ADC_REV: U1.17 (PC2); also elsewhere on the board
ADC_VIN: U1.34 (PB2); also elsewhere on the board
BAND_0: U1.82 (PD0); also elsewhere on the board
BAND_1: U1.83 (PD1); also elsewhere on the board
BranchA1: U1.69 (PA8); also elsewhere on the board
BranchA2: U1.70 (PA9); also elsewhere on the board
BranchB1: U1.67 (PC8); also elsewhere on the board
BranchB2: U1.68 (PC9); also elsewhere on the board
CC1USB: U1.93 (PB6); also elsewhere on the board
CC2USB: U1.91 (PB4); also elsewhere on the board
CLK0: U1.51 (PB12); also elsewhere on the board
CLK1: U1.52 (PB13); also elsewhere on the board
DAC_ENV1: U1.33 (PB1); also elsewhere on the board
DAC_ENV2: U1.50 (PB11); also elsewhere on the board
DAH: C81.2, JP13.3, U1.98 (PE1)
DIT: C80.2, JP6.3, JP13.1, U1.97 (PE0)
GND: C1.1, C2.1, C3.1, C4.1, C5.1, C6.1, C7.1, C8.1, C74.1, C75.1, C76.1, C77.2, C78.2, C80.1, C81.1, C82.2, C83.2, JP2.6, JP3.1, JP4.4, MIC_2.1, Q31.2 (S), Q32.2 (S), Q33.2 (S), R88.2, R90.1, R91.2, R93.1, R95.2, R99.2, R100.2, R103.2, R152.2, R153.2, R154.1, SW6.3, SW6.4, SW7.3, SW7.4, SW9.3, SW9.4, SW10.3, SW10.4, SW11.3, SW11.4, SW12.3, SW12.4, SW13.1, SW13.3, SW13.4, U1.23 (VSS), U1.35 (VSSA), U1.48 (VSS), U1.63 (VSS), U1.74 (VSS), U1.99 (VSS), U2.2 (GND), U3.2, U15.1, U16.1, U17.0 (EP), U17.A1B12 (GND), U17.B1A12 (GND), U20.1, U21.2, X2.5, X3.5; also elsewhere on the board
I2S3_SD: U1.92 (PB5); also elsewhere on the board
I2S_CK: U1.90 (PB3); also elsewhere on the board
I2S_WS: U1.78 (PA15); also elsewhere on the board
LCD_BL: R146.2, U1.96 (PB9)
LCD_CS: JP3.7, U1.42 (PE11)
LCD_DC: JP3.6, U1.44 (PE13)
LCD_RST: JP3.5, U1.41 (PE10)
LCD_SCL: JP3.3, U1.43 (PE12)
LCD_SDA: JP3.4, U1.45 (PE14)
LPF_0: U1.1 (PE2); also elsewhere on the board
LPF_1: U1.2 (PE3); also elsewhere on the board
LPF_2: U1.3 (PE4); also elsewhere on the board
LPF_3: U1.4 (PE5); also elsewhere on the board
LPF_4: U1.5 (PE6); also elsewhere on the board
L_STMDAC: U1.20 (PA0); also elsewhere on the board
MCU_PWR_HOLD: U1.47 (PB10); also elsewhere on the board
MIC1: C79.1, R98.2, U1.22 (PA2)
MIC2: C84.1, R101.2, U1.25 (PA3)
MIC3: U1.40 (PE9); also elsewhere on the board
unnamed: C77.1, R94.2, R95.1, R98.1
unnamed: C78.1, R96.2, R97.1
unnamed: C79.2, JP6.1, R97.2
unnamed: C82.1, R101.1, R102.2, R103.1
unnamed: C83.1, R104.2, R105.1
unnamed: C84.2, MIC_2.2, R105.2
unnamed: JP3.8, R146.1
unnamed: JP13.2, U21.1, X2.2
unnamed: JP13.4, U3.1, X2.4
unnamed: JP6.2, JP13.5
unnamed: JP13.6, U20.2, X2.3
unnamed: JP14.2, JP15.2, JP16.2, JP17.2, JP18.2, R92.1, R93.2, SW6.2, SW7.2, SW9.2, SW10.2, SW11.2
unnamed: LED1.C, R91.1
unnamed: LED2.C, R88.1
unnamed: Q31.3 (D), R149.1, R157.2
unnamed: JP19.7, Q31.1 (G), R154.2, U1.55 (PD8)
unnamed: Q32.3 (D), R150.1, R156.1
unnamed: JP19.6, Q32.1 (G), R153.1, U1.56 (PD9)
unnamed: Q33.3 (D), R151.1, R155.1
unnamed: JP19.5, Q33.1 (G), R152.1, U1.57 (PD10)
unnamed: R149.2, X3.2
unnamed: R150.2, X3.4
unnamed: R151.2, X3.3
unnamed: JP20.1, U1.71 (PA10)
unnamed: JP20.2, U1.32 (PB0)
unnamed: JP20.3, U1.54 (PB15)
unnamed: JP20.4, U1.80 (PC11)
unnamed: JP20.5, U1.81 (PC12)
unnamed: JP20.6, U1.7 (PC13)
unnamed: JP20.7, U1.8 (PC14)
unnamed: JP20.8, U1.9 (PC15)
unnamed: JP19.8, U1.89 (PD7)
unnamed: R148.1, U1.61 (PD14)
unnamed: R148.2, U1.62 (PD15)
unnamed: JP7.3, U1.38 (PE7)
unnamed: JP7.2, U1.39 (PE8)
unnamed: JP7.1, U1.46 (PE15)
unnamed: R1.1, U1.12 (PF0)
unnamed: JP7.7, U1.13 (PF1)
unnamed: JP7.6, U1.19 (PF2)
unnamed: JP7.5, U1.10 (PF9)
unnamed: JP7.4, U1.11 (PF10)
unnamed: C74.2, R89.2, SW13.2, U1.14 (PG10)
unnamed: C76.2, L6.2, U1.37 (VDDA)
unnamed: C7.2, C8.2, U1.36 (VREF+)
unnamed: R2.2, U2.1 (*STANDBY)
unnamed: R1.2, U2.3 (OUT)
unnamed: R100.1, U17.A5 (CC1)
unnamed: R99.1, U17.B5 (CC2)
PB8_BOOT: R90.2, SW12.2, U1.95 (PB8)
PWM_BIAS: U1.59 (PD12); also elsewhere on the board
RF_EN: U1.65 (PC6); also elsewhere on the board
RF_EN2: U1.79 (PC10); also elsewhere on the board
RX_EN: U1.66 (PC7); also elsewhere on the board
R_STMDAC: U1.21 (PA1); also elsewhere on the board
SD_CS: JP2.2, U1.26 (PA4)
SD_MISO: JP2.5, U1.28 (PA6)
SD_MOSI: JP2.3, U1.29 (PA7)
SD_SCK: JP2.4, U1.27 (PA5)
STATUS_LED: LED2.A, U1.94 (PB7)
SWCLK: JP4.3, U1.77 (PA14)
SWDIO: JP4.2, U1.76 (PA13)
SW_4: JP15.1, SW7.1, U1.87 (PD5)
SW_5: JP14.1, SW6.1, U1.88 (PD6)
SW_DOWN: JP16.1, SW9.1, U1.84 (PD2)
SW_SELECT: JP18.1, SW11.1, U1.85 (PD3)
SW_UP: JP17.1, SW10.1, U1.86 (PD4)
TEST_CLK: U1.53 (PB14); also elsewhere on the board
USB_DN: U1.72 (PA11), U16.2, U17.A7 (DN1), U17.B7 (DN2)
USB_DP: U1.73 (PA12), U15.2, U17.A6 (DP1), U17.B6 (DP2)

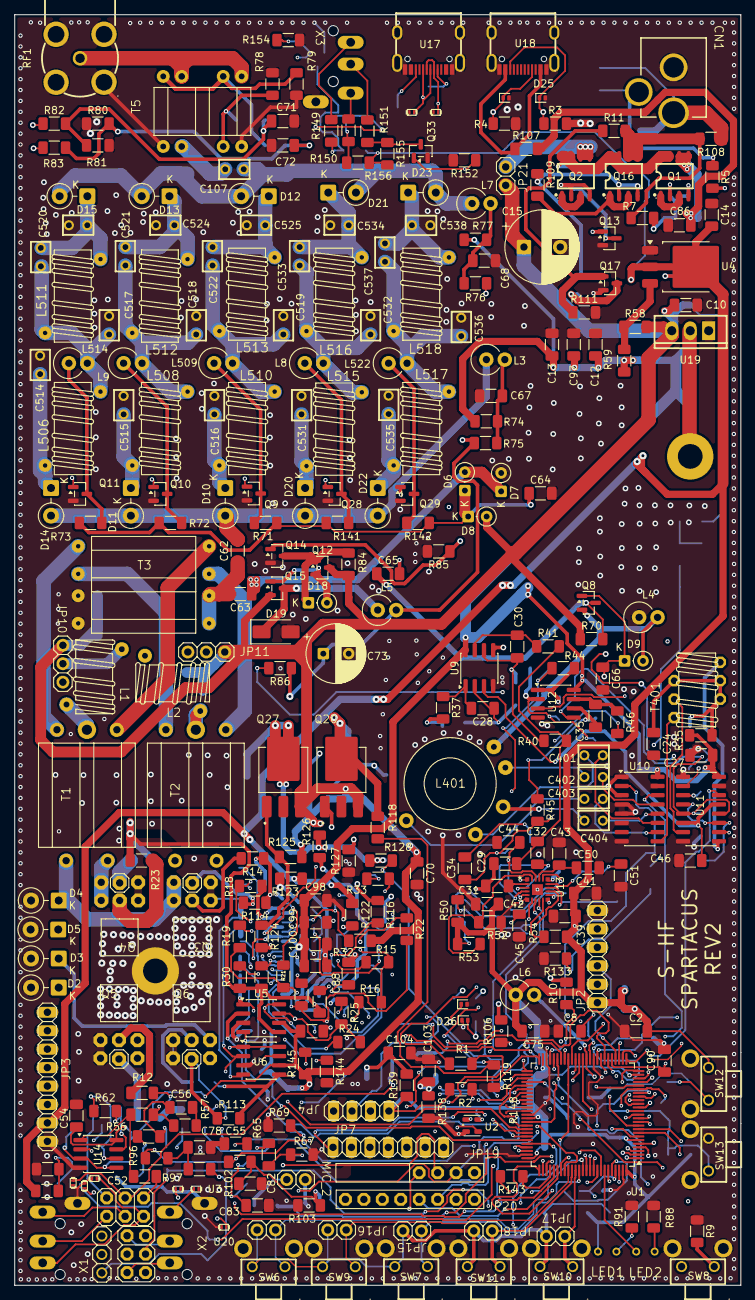
[picture p6: board v1sch.kicad_pcb from above]

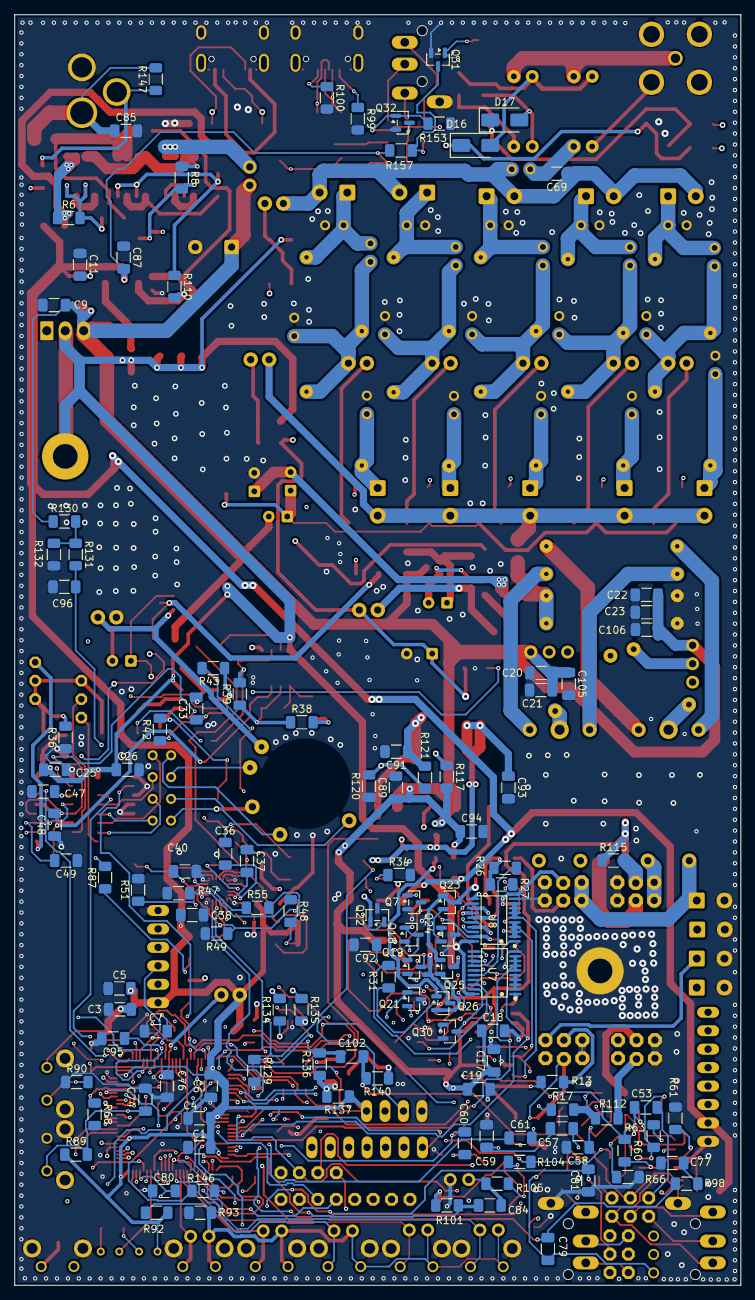
[picture p7: board v1sch.kicad_pcb from below]

Board: 6 copper layers, 100.0 x 175.0 mm, 436 parts (120 on the bottom side), 292 nets.
