vpcsln/spartacus_PCB_REV1/(commit log)

2026-07-27 Initial import with reproducible KiCad libraries
2026-10-18 Update rev1 PCB and schematics with existing project libraries
